jostroeb/hpower_LED_driver/LED_Treiber_Präsentation.pdf

Zielgruppe:
Ziel:

# LED-Beleuchtung

TMT22
Projektvorstellung Leiterplattenentwicklung

Simon Follmann (1134578), Johannes Ströbel (9589176)

# Leiterplattenentwicklung- Projektarbeit

### 4. Dezember 2023

1

3
4
5
6
7

2

Gliederung

Projektidee

Ausblick und Verbesserungsvorschläge

Platinenlayout

LED-Treiber

Mikrocontroller & USB-PD Spannungsversorgung

Anforderungsprofil

Blockschaltbild

ZEISS | 4. Dezember 2023 | 2

Follmann / Ströbel

Follmann

Ströbel

Follmann

Ströbel

Ströbel

Follmann

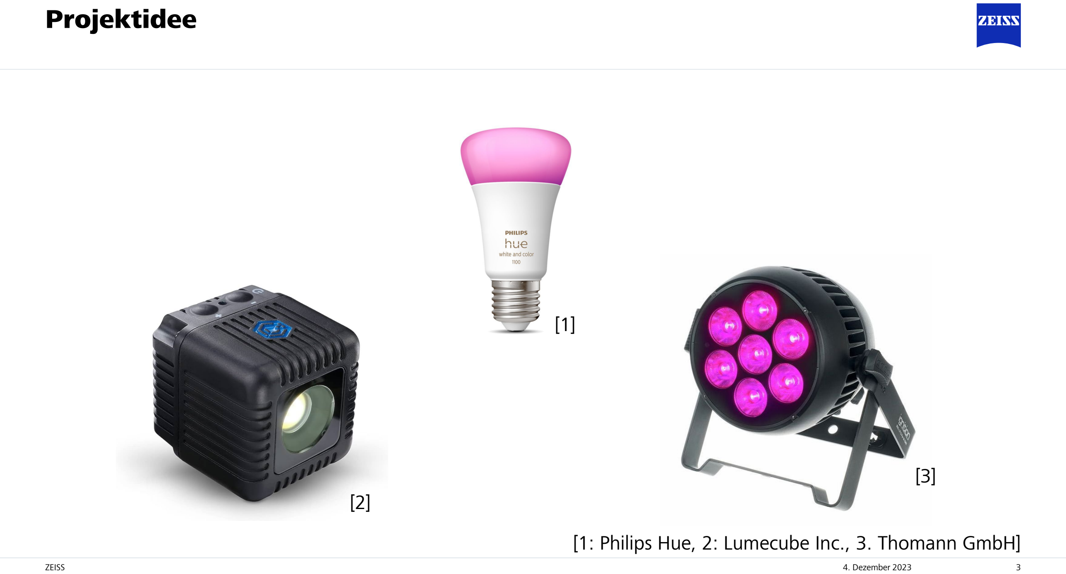
[picture p1: page 3]

Projektidee

[1: Philips Hue, 2: Lumecube Inc., 3. Thomann GmbH]

[1]

[2]

[3]

Anforderungen

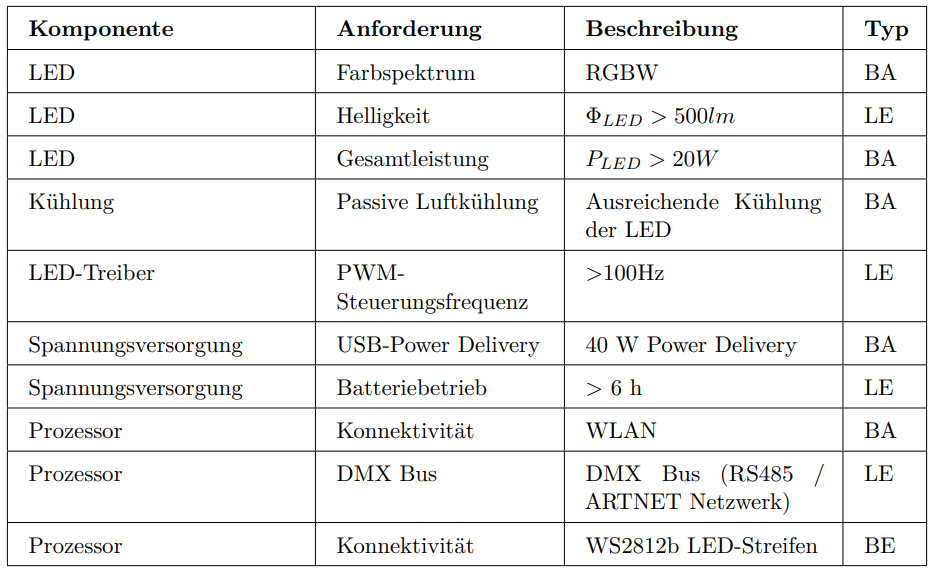
[picture p2: figure]

Blockschaltbild

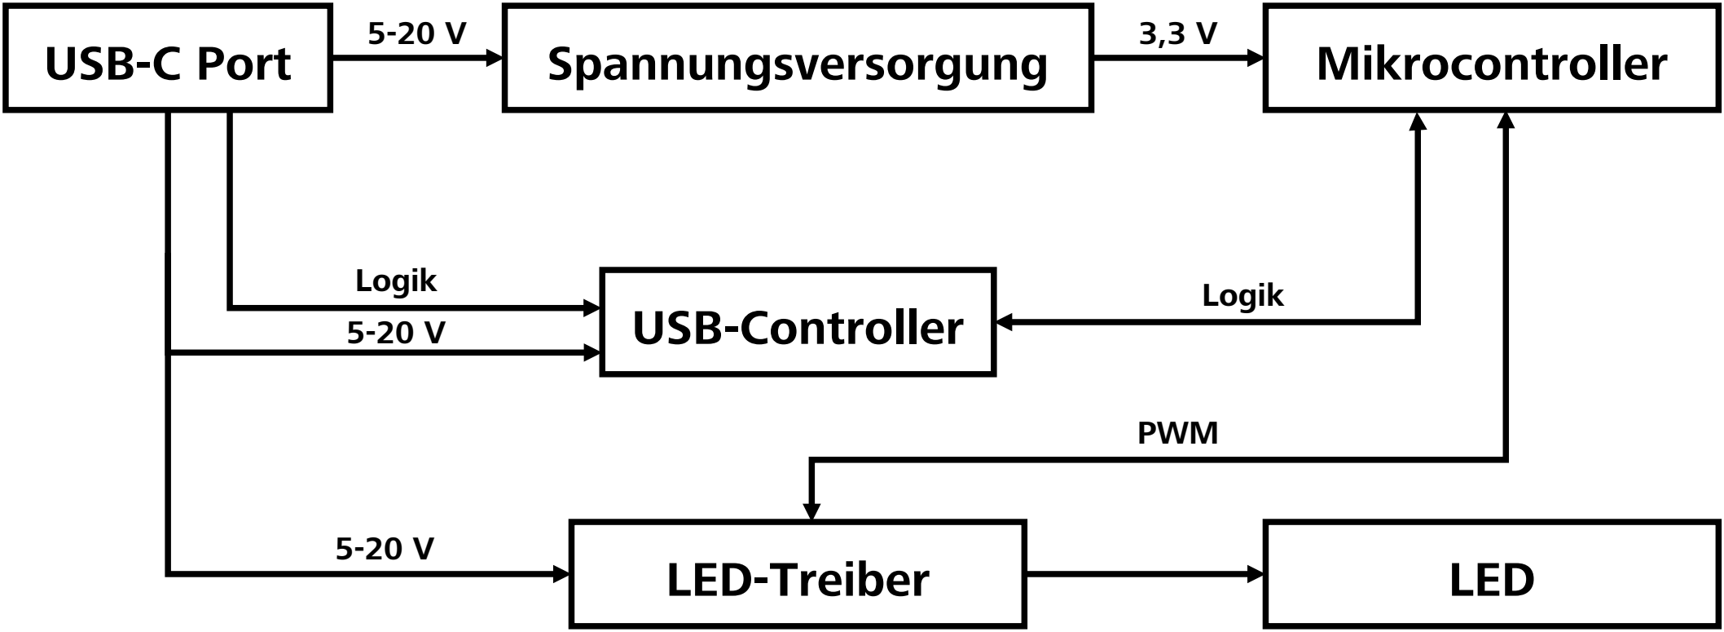
[picture p3: figure]
USB-C Port; USB-Controller; Mikrocontroller; LED-Treiber; LED; Spannungsversorgung; Logik; PWM

Mikrocontroller
Software

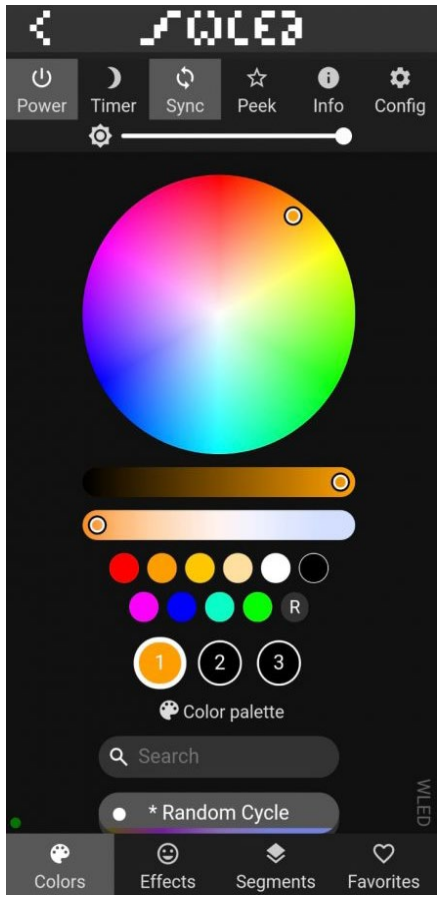
[picture p4: figure]

W-LED
- PWM & Pixelansteuerung
- WLAN Anbindung
- Opensource Software-Projekt
- Browserbasiertes User Interface
- ESP32 kompatibel

Mikrocontroller
Hardware ESP32
- 4 PWM-Pins für LED-Steuerung
- 3,3 V basierter Mikrocontroller
- UART-Schnittstelle für
Programmierung
- Reset und Bootloader Taster
- I2C-Schnittstelle zu USB-Controller
- 2 Input Pins für Fehlermeldung von USB-Controller

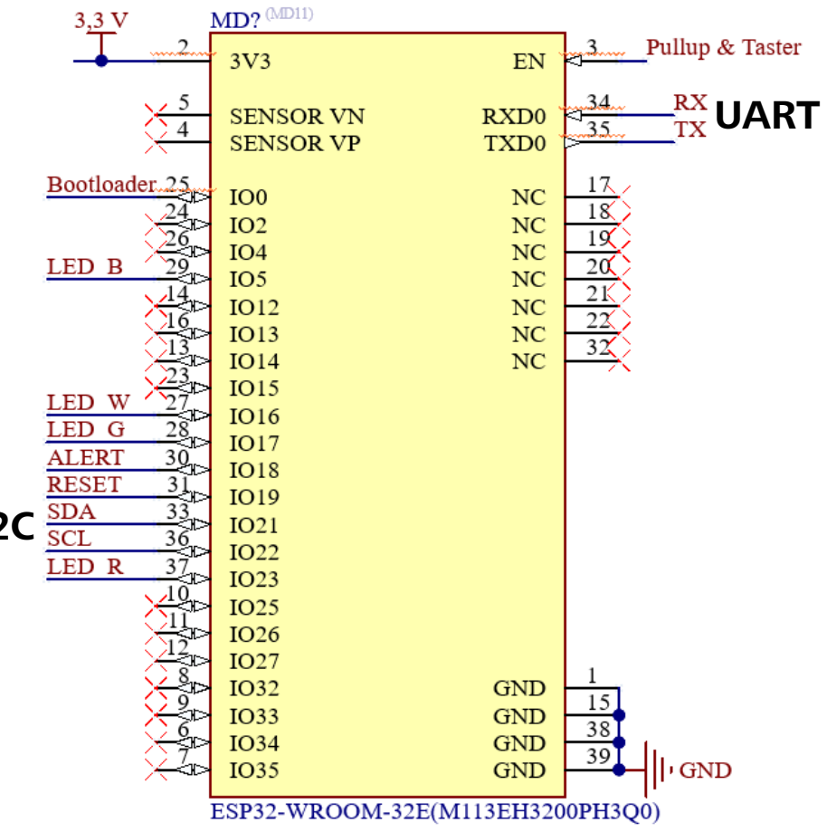
[picture p5: figure]
UART

I2C

USB-Power Delivery Standard Provider-Consumer Beziehung (Source-Sink)

- Kommunikation zwischen Quelle und Senke
- Verhandlung des Power-Contracts

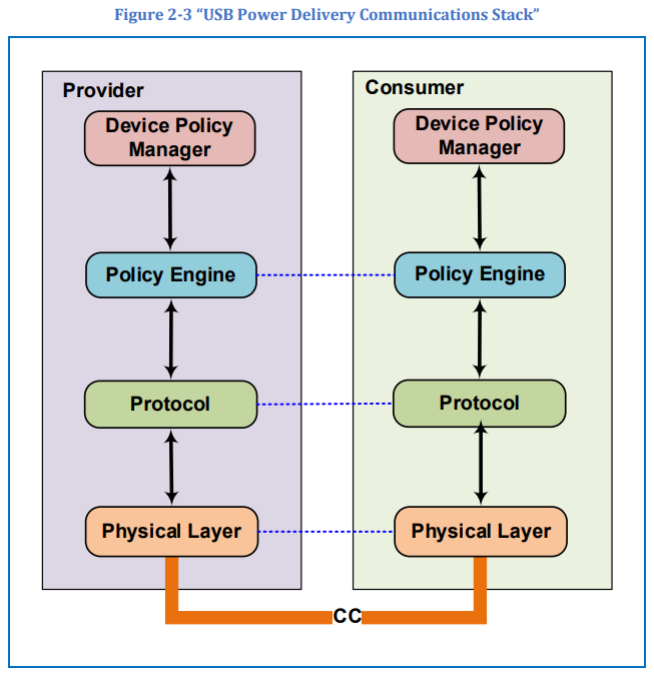
[picture p6: figure]

[usb.org: USB-PD Specification Rev 3.1 2023-10]

USB-Power Delivery Standard Power Data Object (PDO)

Leistungsbereitstellung
abhängig von Netzteil
Pstandby = 3,1 W
Pmax = 37,1 W
→ 5 V 3 A
→ 9 V 2-3 A
→ 15 V 2-3 A (Pmax)
→ 20 V 2 A (Pmax)
Imax = 3A

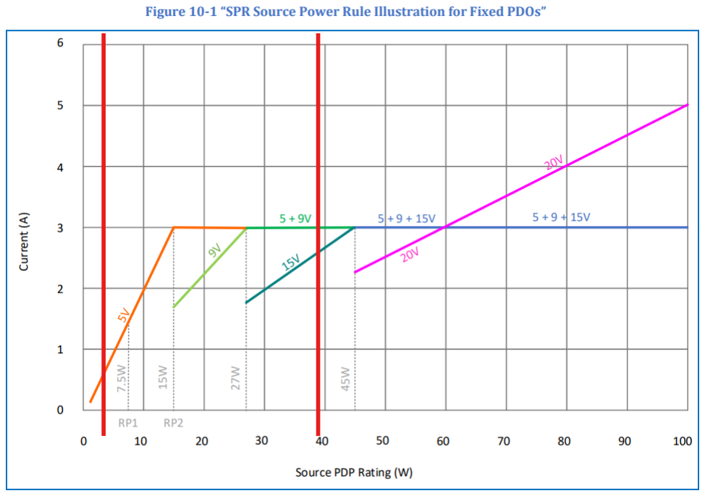
[picture p7: figure]

[usb.org: USB-PD Specification Rev 3.1 2023-10]

USB-Power Delivery Standard Änderung Versorgungsspannung Ubus

5V vSafe → PDO → neue Ubus Power Data Object (PDO) ≈
Leistungsprofil

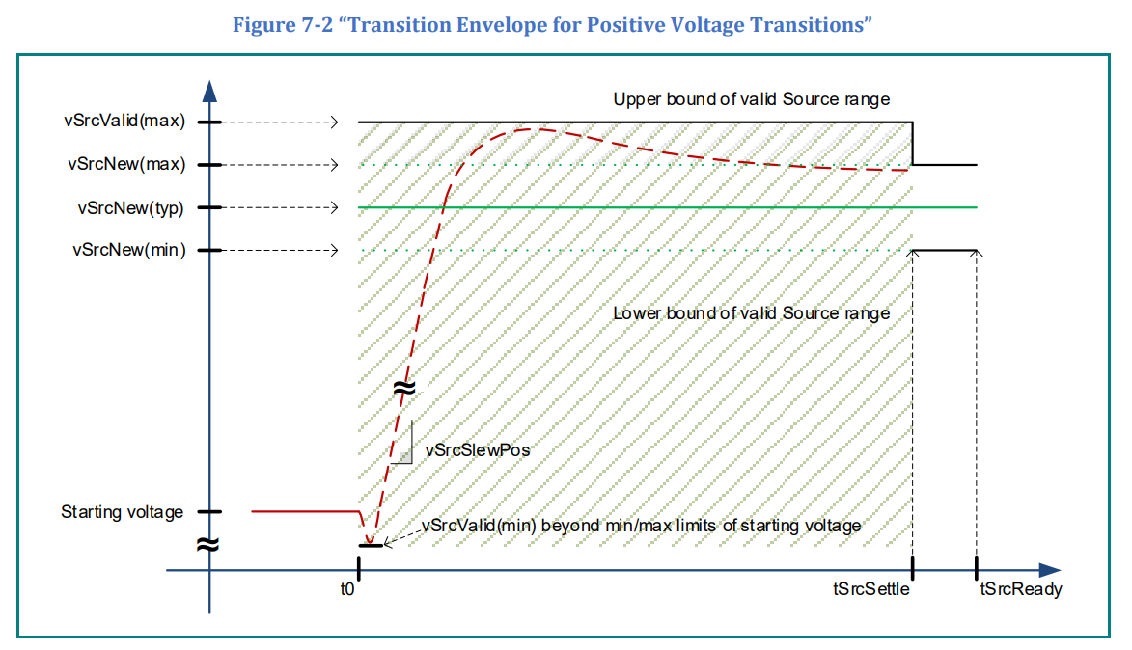
[picture p8: figure]

[usb.org: USB-PD Specification Rev 3.1 2023-10]

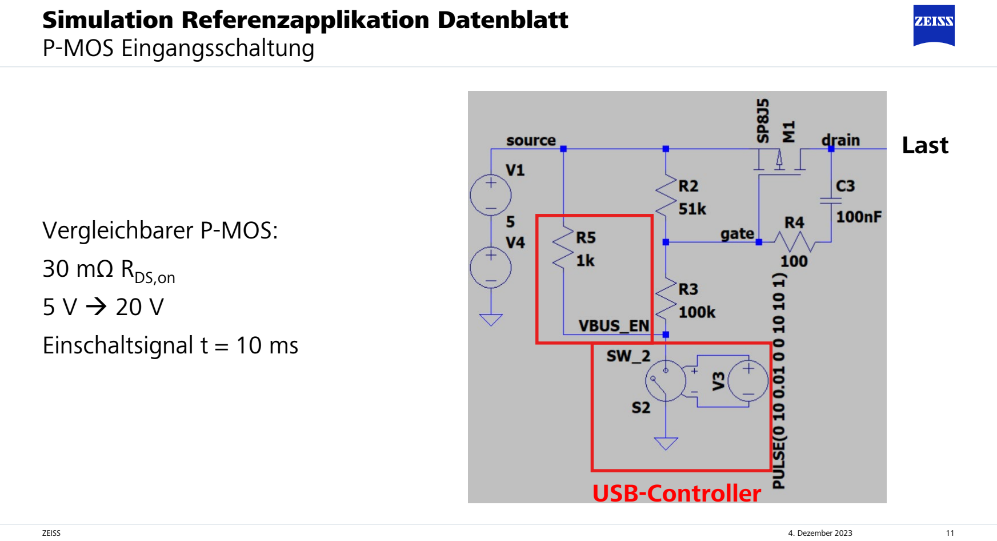
[picture p9: page 11]

Simulation Referenzapplikation Datenblatt P-MOS Eingangsschaltung

Vergleichbarer P-MOS:
30 mΩ RDS,on
5 V → 20 V
Einschaltsignal t = 10 ms

USB-Controller

Last

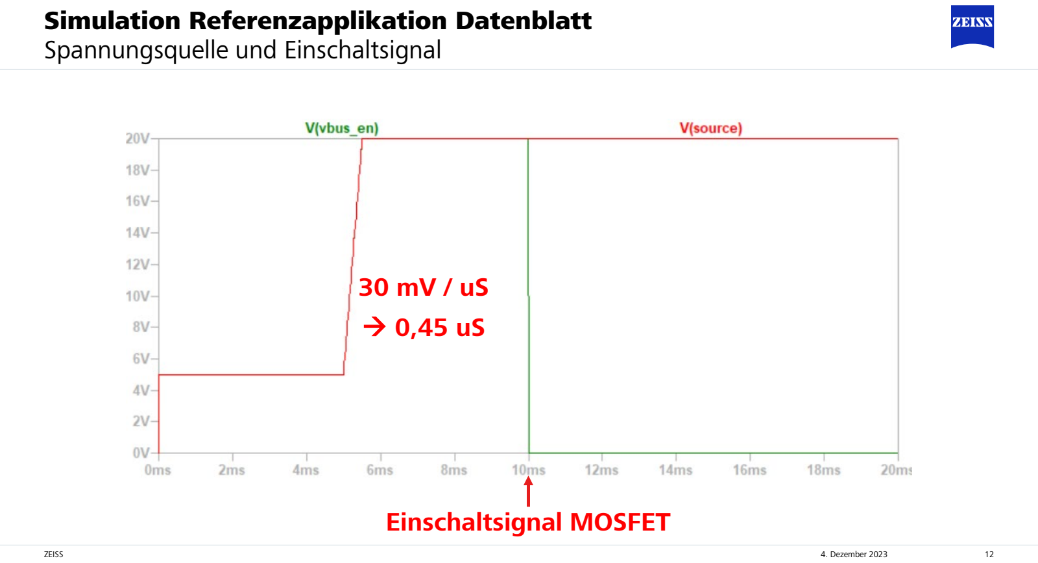
[picture p10: page 12]

Simulation Referenzapplikation Datenblatt Spannungsquelle und Einschaltsignal

Einschaltsignal MOSFET

### 30 mV / uS

→ 0,45 uS

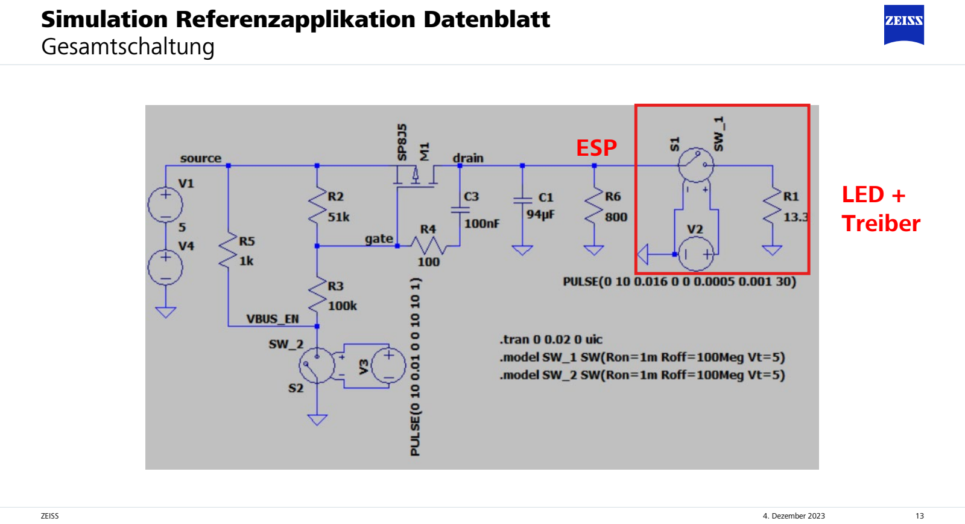
[picture p11: page 13]

Simulation Referenzapplikation Datenblatt Gesamtschaltung

LED +
Treiber

ESP

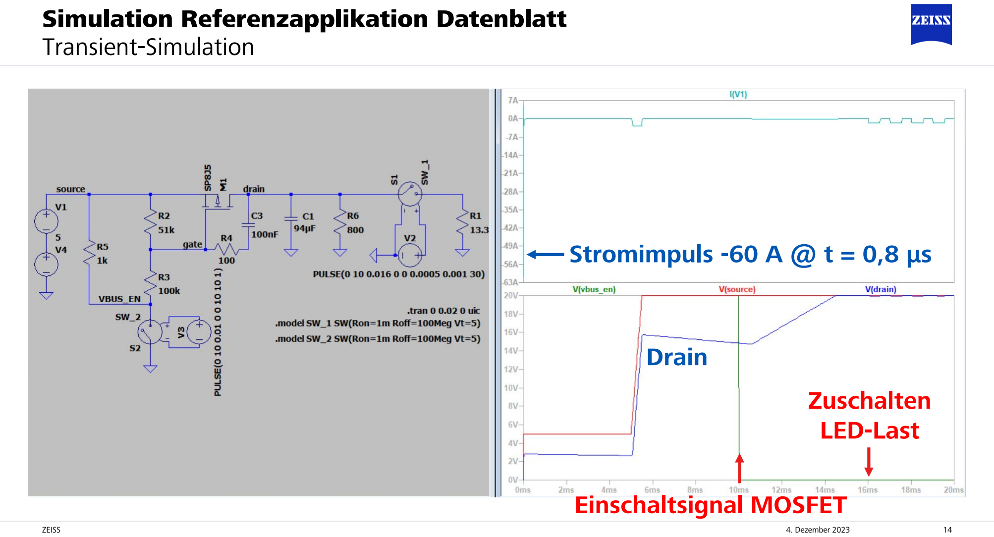
[picture p12: page 14]

Simulation Referenzapplikation Datenblatt Transient-Simulation

Einschaltsignal MOSFET

Zuschalten
LED-Last

Drain

Stromimpuls -60 A @ t = 0,8 µs

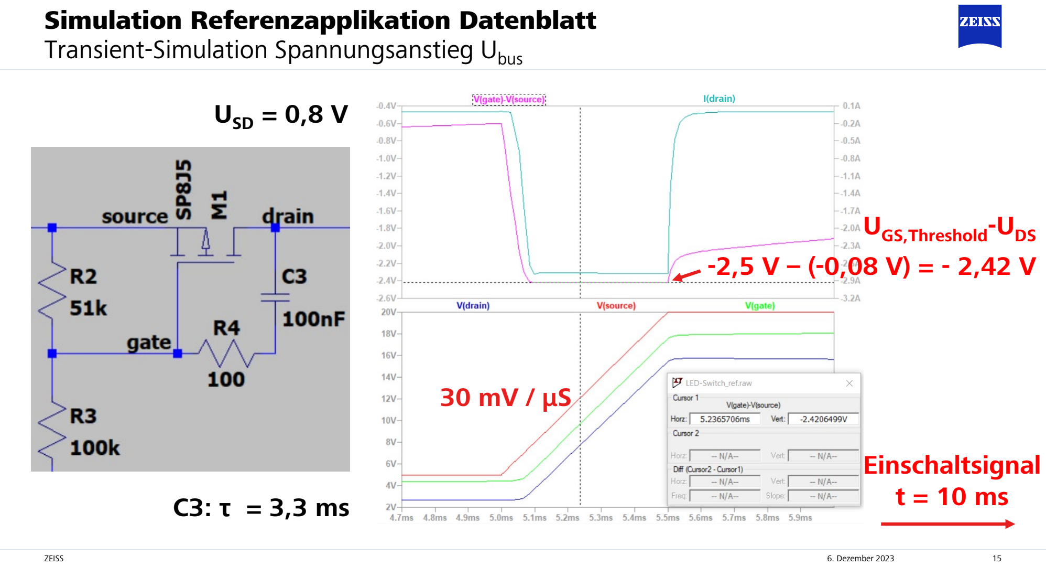
[picture p13: page 15]

Simulation Referenzapplikation Datenblatt Transient-Simulation Spannungsanstieg Ubus

ZEISS | 6. Dezember 2023 | 15

UGS,Threshold-UDS
-2,5 V – (-0,08 V) = - 2,42 V

Einschaltsignal
t = 10 ms C3: τ = 3,3 ms

I(drain)

### 30 mV / µS

USD = 0,8 V

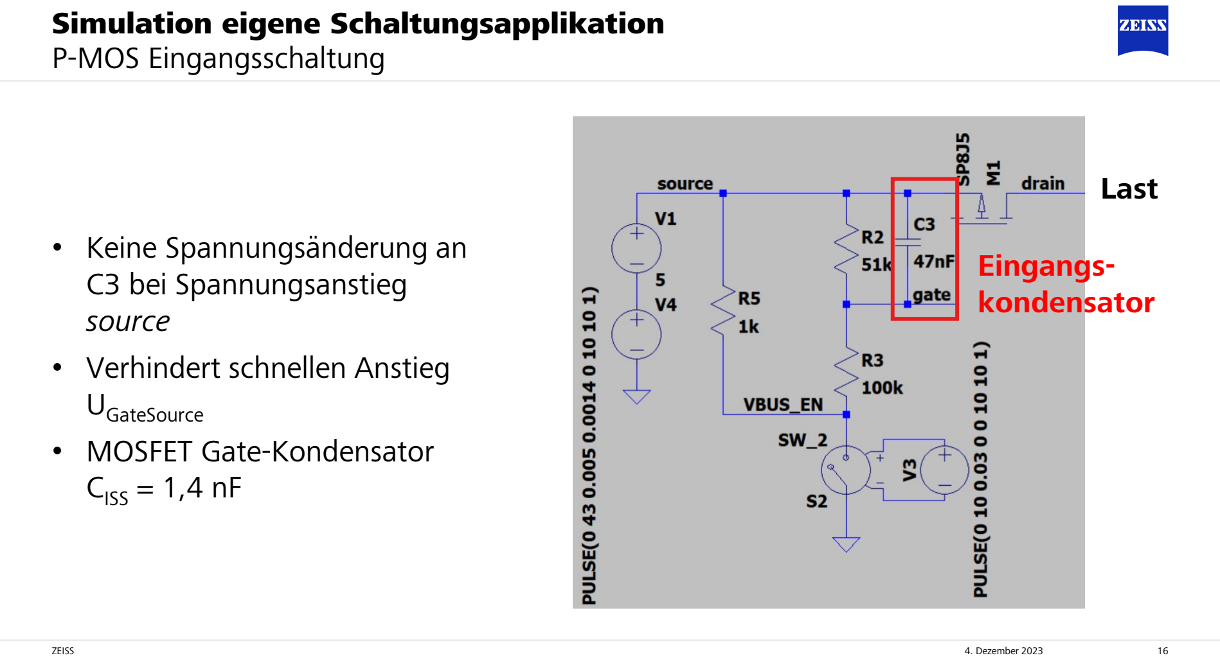
[picture p14: page 16]

Simulation eigene Schaltungsapplikation P-MOS Eingangsschaltung

- Keine Spannungsänderung an C3 bei Spannungsanstieg
source
- Verhindert schnellen Anstieg
UGateSource
- MOSFET Gate-Kondensator
CISS = 1,4 nF

Eingangs-kondensator

Last

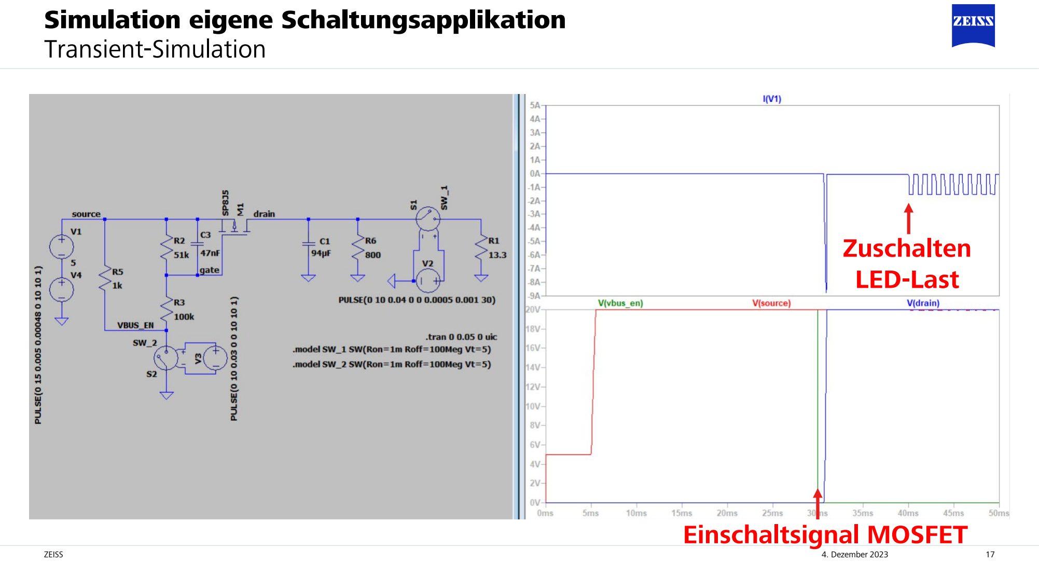
[picture p15: page 17]

Simulation eigene Schaltungsapplikation Transient-Simulation

Einschaltsignal MOSFET

Zuschalten
LED-Last

Simulation eigene Schaltungsapplikation Transient-Simulation UGS

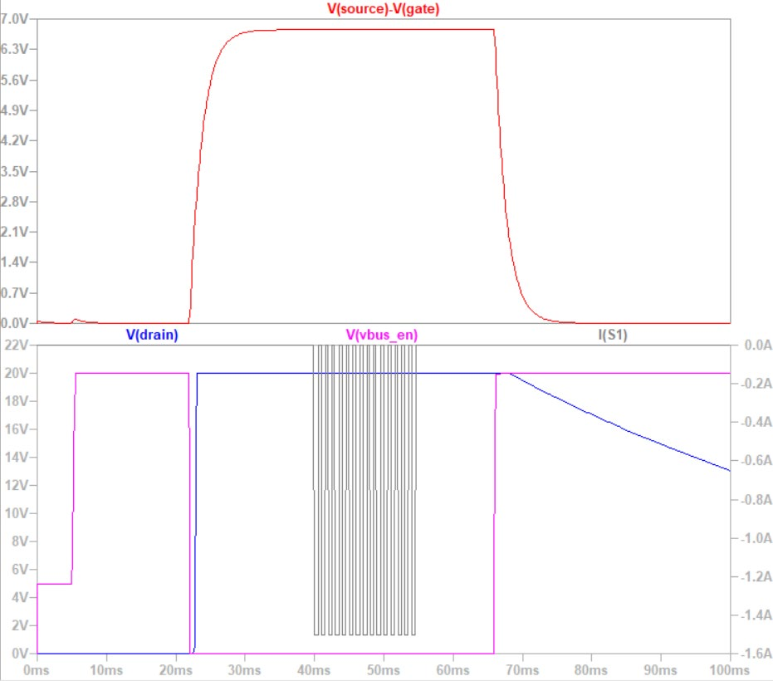
[picture p16: figure]

- Erkennbare Lade/-Entladekurve Kondensator
- Spannungsspitze < Ugs, threshold bei Ugs bei t = 5 ms wegen
Spannungsanstieg,

Simulation Referenzapplikation Datenblatt Transient-Simulation UGS

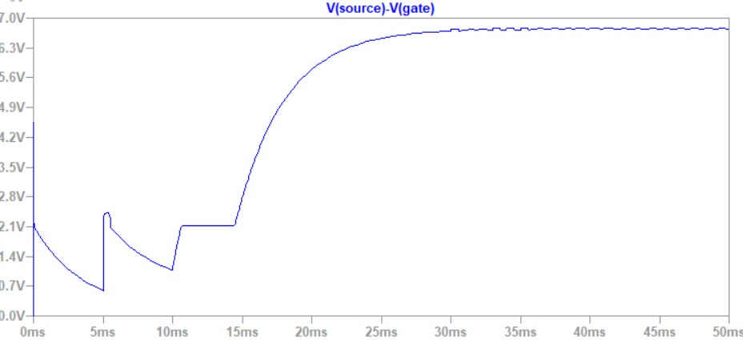
[picture p17: figure]

Unerwünschtes Verhalten

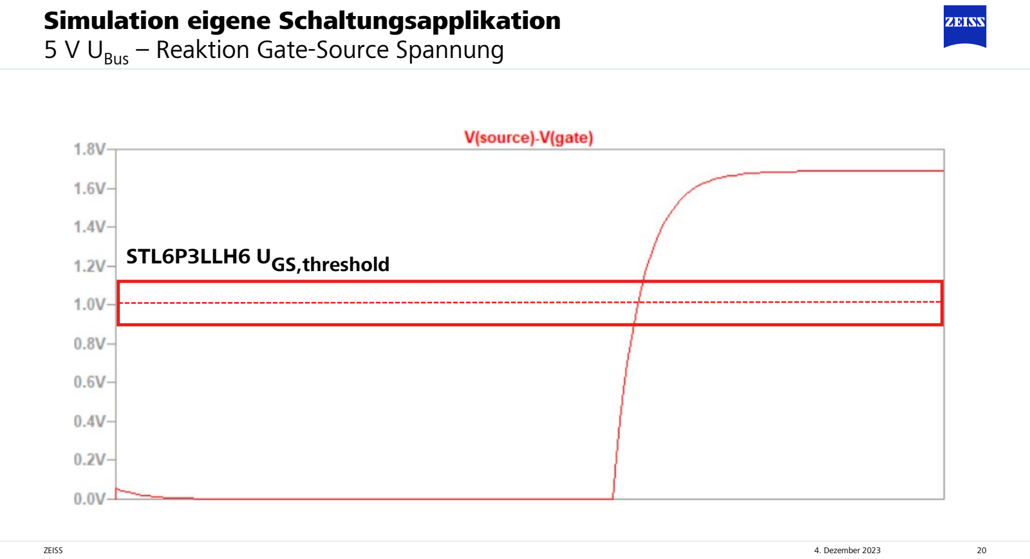
[picture p18: page 20]

Simulation eigene Schaltungsapplikation 5 V UBus – Reaktion Gate-Source Spannung

STL6P3LLH6 UGS,threshold

Simulation eigene Schaltungsapplikation 48 V Bus – Reaktion Gate-Source Spannung

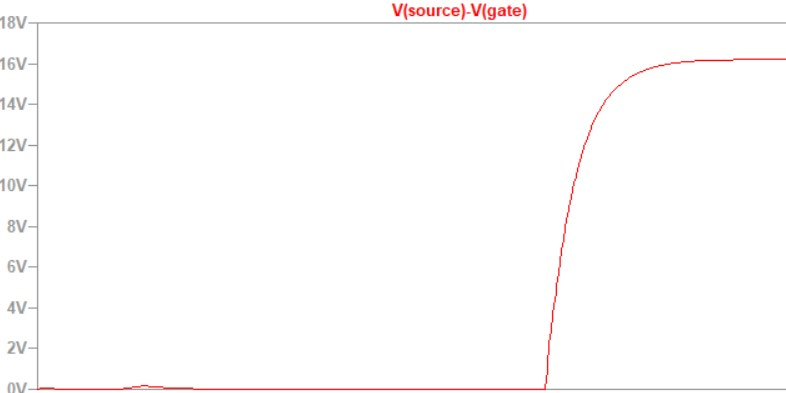
[picture p19: figure]

- Extender Power Range
(bis 48 V / 240 W)
- UGS = ± 20 V
- ESD-Schutzdiode ab 22 V

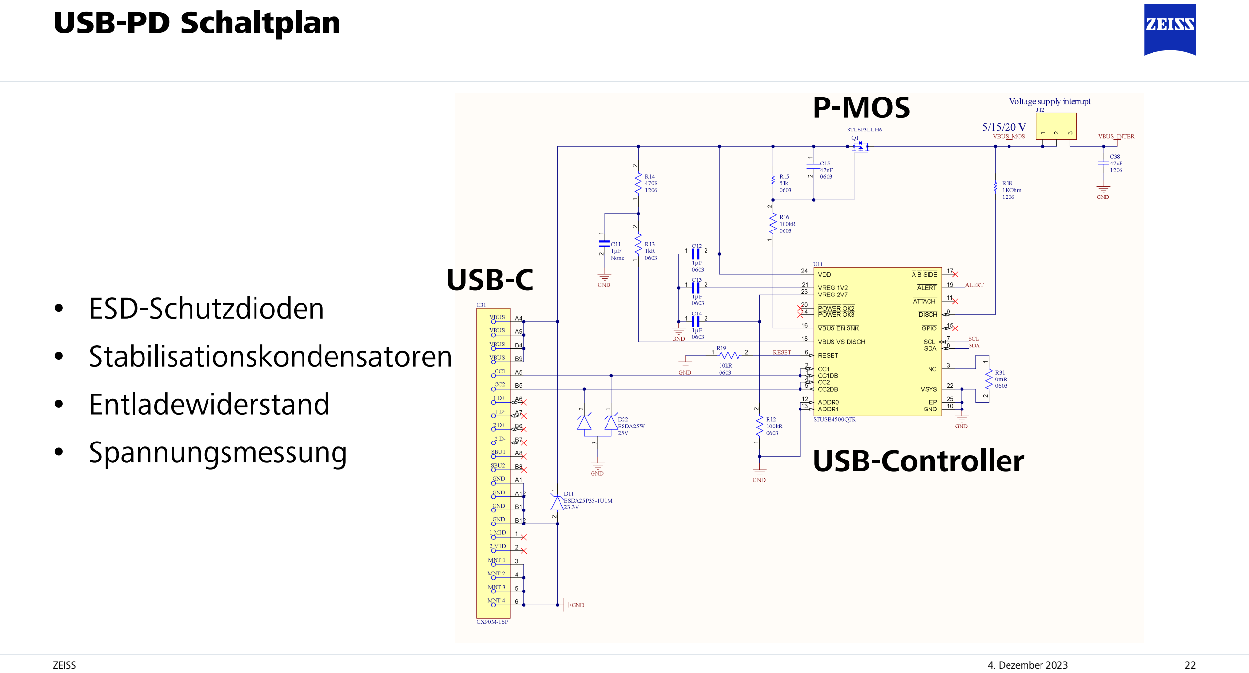
[picture p20: page 22]

USB-PD Schaltplan

- ESD-Schutzdioden
- Stabilisationskondensatoren
- Entladewiderstand
- Spannungsmessung

USB-C

USB-Controller

P-MOS

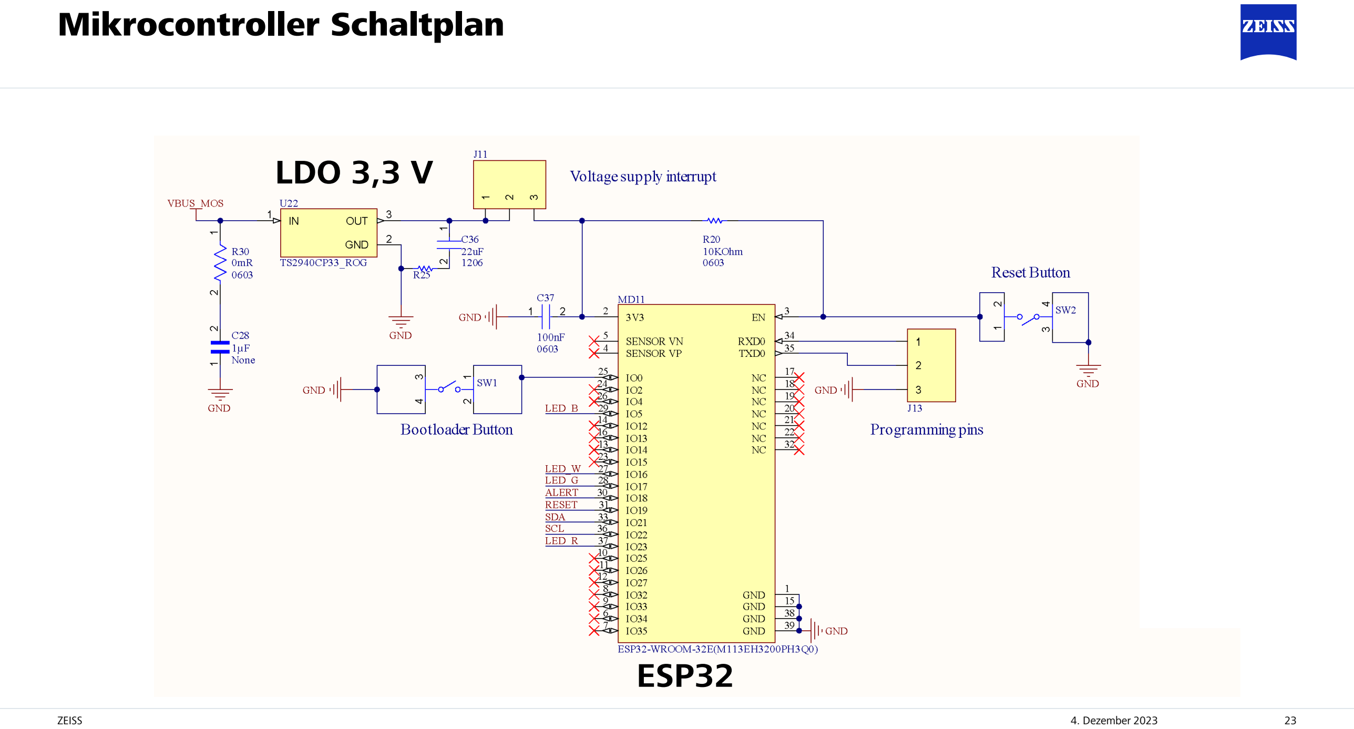
[picture p21: page 23]

Mikrocontroller Schaltplan

ESP32

LDO 3,3 V

LED-Beleuchtungstreiber
Auswahl der LED

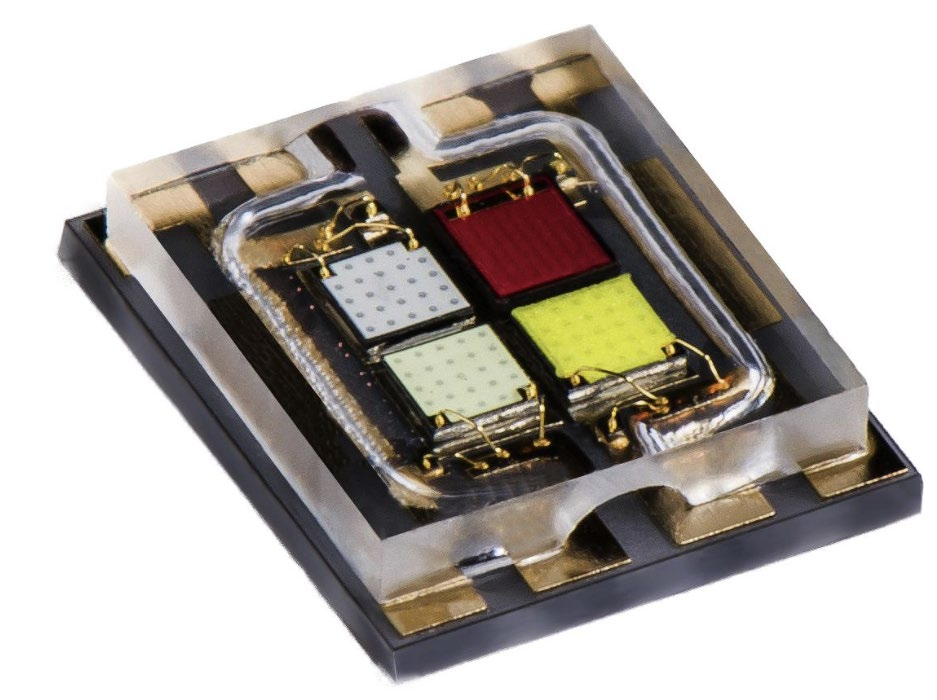
[picture p22: figure]

- Leistung
- Farbvielfalt
- Maximaler Strom Imax = 2A als wichtiger Faktor
- Steuerfrequenz: 1 kHz

Hauptkriterien

LED-Beleuchtungstreiber
Auswahl des LED-Treibers

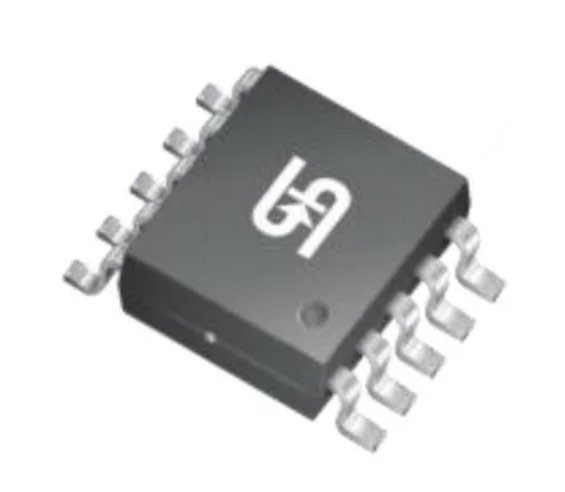
[picture p23: figure]

- Maximalstrom von I
max = 2 A
- Je vier ICs steuern eine Farbe an
- Berücksichtigung von Eingangsspannungsschwankungen durch USB-P (4.5 V – 75 V)
- Hohes Dimmungsverhältnis möglich

Hauptkriterien

LED-Beleuchtungstreiber
Schaltplan

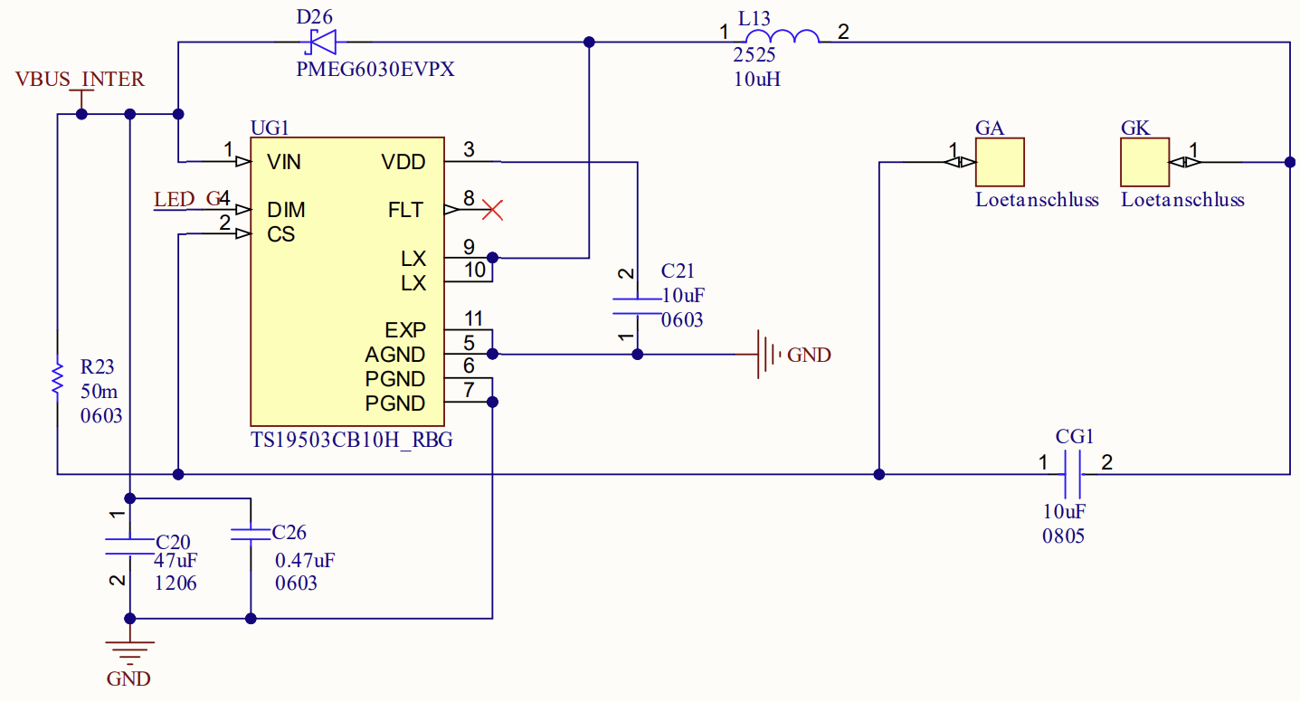
[picture p24: figure]

LED-Beleuchtungstreiber
Berechnung des Stromflusses

https://www.taiwansemi.com/en/products/details/TS19503CB10H

AAABBBBBAAB\

Parameter | Symbol | Non-Dimming | Unit | Remark
Supply Voltage | VIN | 20 | V
Output Voltage | VOUT | 3.9 | V
LED Current | IOUT | 2 | A
Inductor | L | 10 | μH
Ambient Temperature | TC | 25 | ⁰C
Thermal Resistence | RtiJC | 31 | ⁰C/W | Parameter Fixed.
Duty Cycle | D | 21.50 | %
| TON | 1.946 | μs
TOFF | TOFF | 7.65 | μs
Operating Frequency | F | 102.6 | kHz
IC Total Power Dissipation | P | 0.83 | W | PASS
Junction Temperature | TJ | 50.73 | ⁰C

Design Condition

ver.: B2203

System Calculation Form - TS19503CB10H

System Setting TON

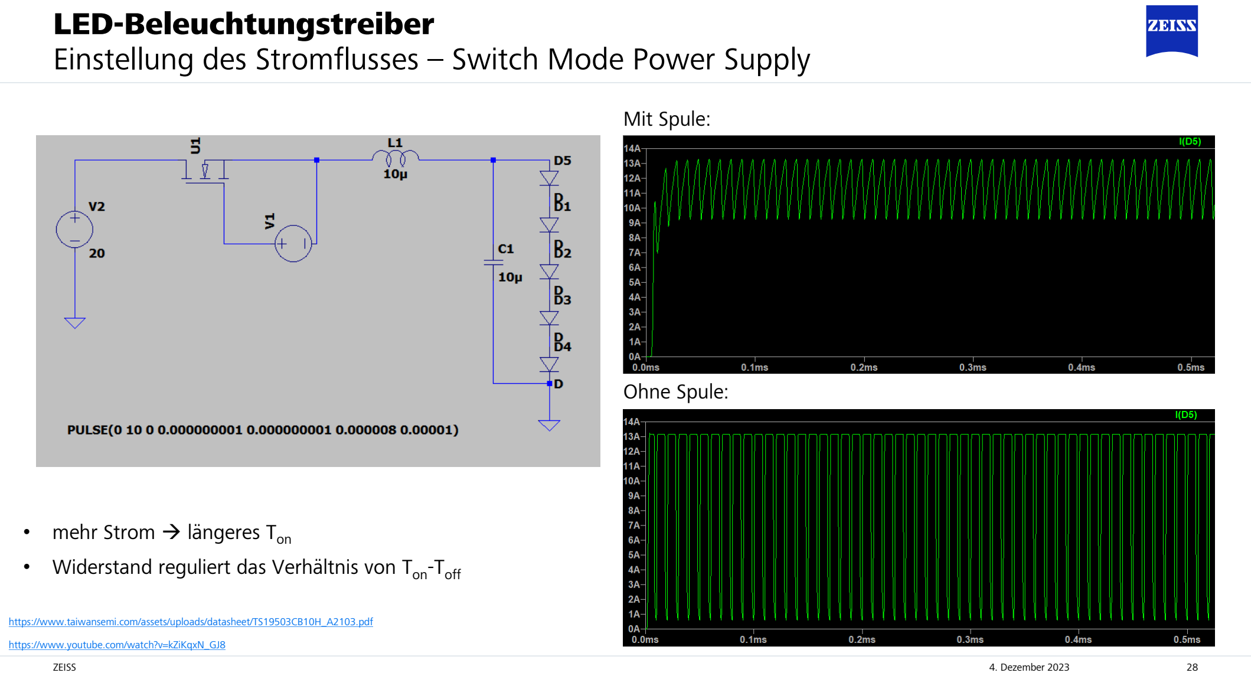
[picture p25: page 28]

LED-Beleuchtungstreiber
Einstellung des Stromflusses – Switch Mode Power Supply

https://www.taiwansemi.com/assets/uploads/datasheet/TS19503CB10H_A2103.pdfhttps://www.youtube.com/watch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

- mehr Strom → längeres Ton
- Widerstand reguliert das Verhältnis von Ton-Toff

Mit Spule:

Ohne Spule:

Kühlung

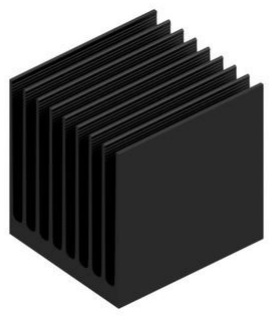
[picture p26: figure]

1.Verlustleistung pro LED
2. Thermische Leistung
3. Gesamte thermische Verlustleistung
4. Maximaler thermischer Widerstand
5. Thermischer Widerstand der PCB
6. Gesamtwiderstand

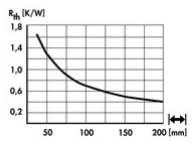
[picture p27: figure]

(Schichten v.u. n. o.: Kühlkörper, Wärmeleitpaste, Alukern (PCB), elektrische Isolation (PCB), Kupfer (PCB), Junction-Case LED)

Layout
LED-PCB

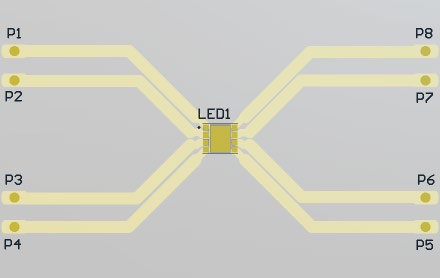
[picture p28: figure]

Layout
3D-Ansicht Oberseite

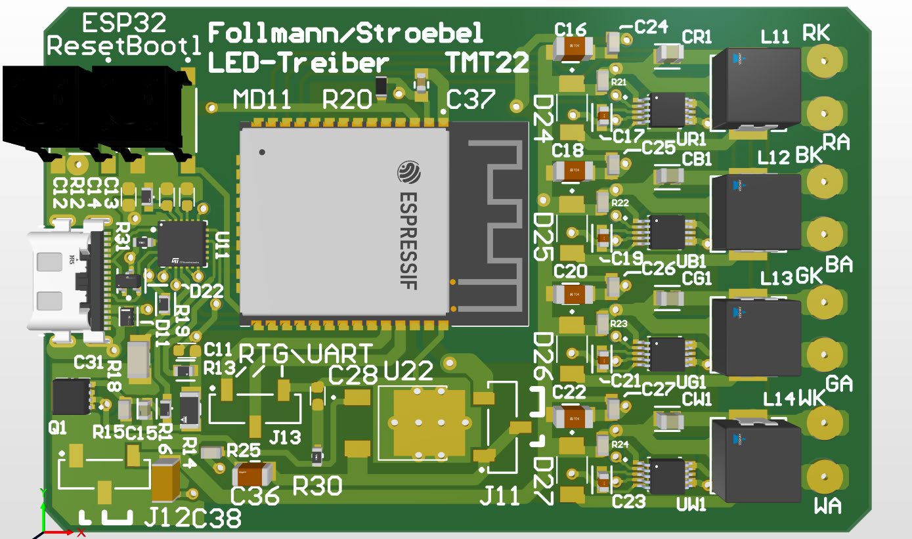
[picture p29: figure]

Bauteilkosten ≈
50 $

Layout
3D-Ansicht Unterseite

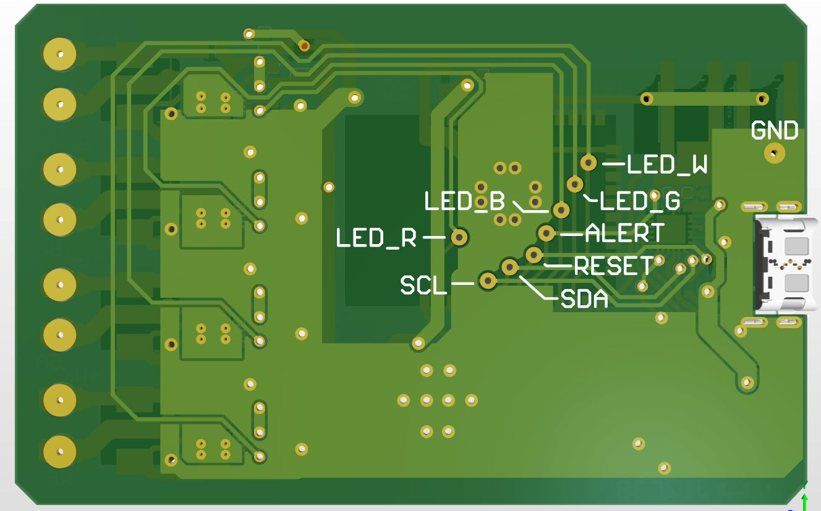
[picture p30: figure]

74 * 47 mm²

Layout
Oberseite

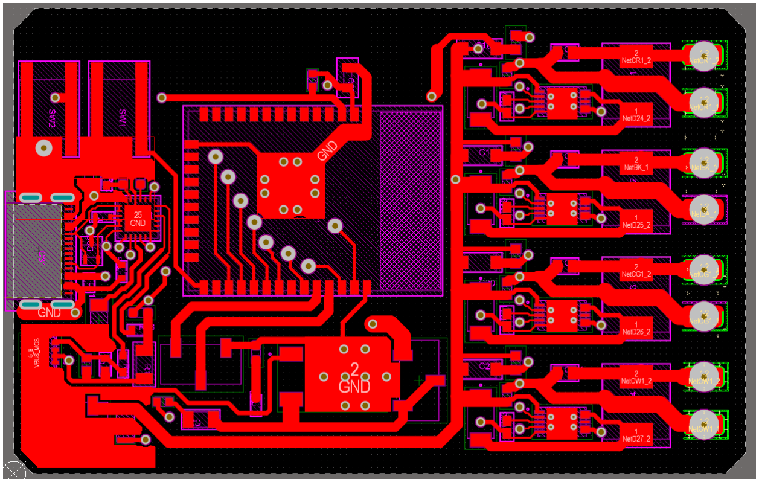
[picture p31: figure]

Layout
Unterseite

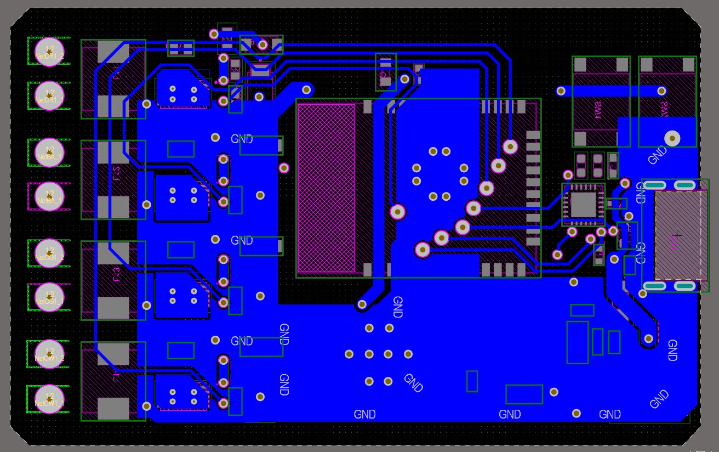
[picture p32: figure]

(links: Trennung P-GND und A-GND von
LED-Treibermodul

Ausblick
Einführung einer Schnittstelle für Displayanschluss

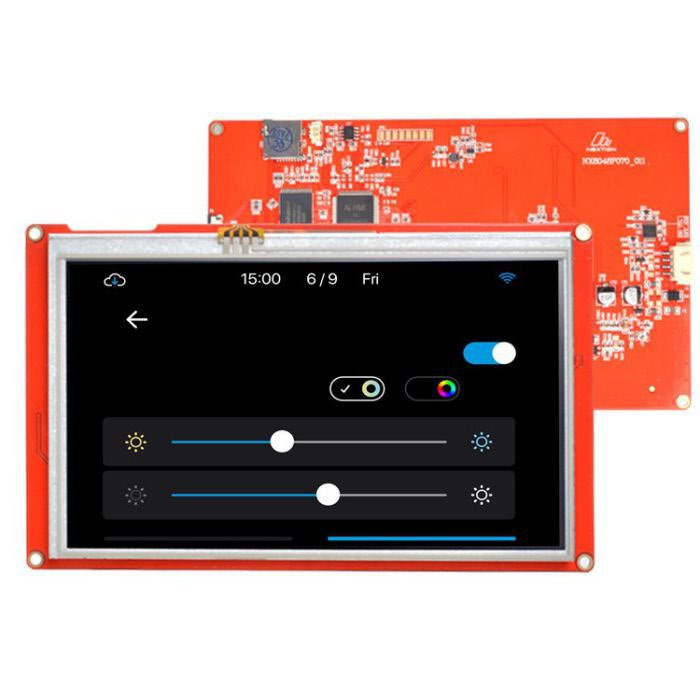
[picture p33: figure]

- Anzeige von Systemparamtern
- Vereinfachte Bedienung und Anpassung
- Zusätzlich weitere Status-LEDs

https://www.antratek.de/nx8048p070-011r

Ausblick
Erweiterung des Farbspektrums

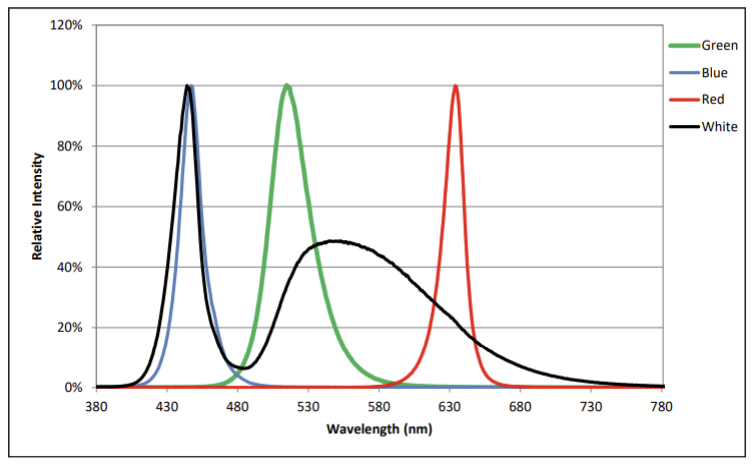
[picture p34: figure]

- Neue Spektren: UV, Amber etc.
- Neue Einsatzgebiete des Treibers
- Verbesserte Farbwiedergabe und Farbbandbreite
- Allgemeine Steigerung der Funktionalität des Systems

https://www.visiontwo.de/marken/claypaky/led-moving-lights/k-eye-k20-hcr/

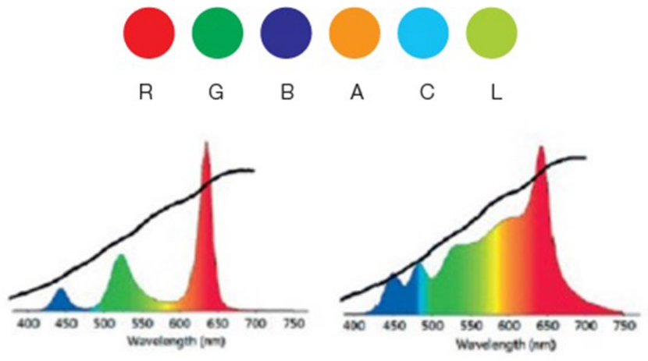
[picture p35: figure]

https://www.mouser.de/datasheet/2/245/Luminus_SBM_40_SC_Datasheet-1499187.pdf

Ausblick
Integration einer DMX-Bus-Schnittstelle
- Professionelle und flexible Steuerung des LED-Treibers
- Vernetzung mehrerer Treiber zu einem koordinierten LED-System
- Adressierbarkeit von LEDs
- Einsatz in umfangreichen Bühnensystemen

https://www.production-partner.de/basics/dmx-%E2%88%92-grundlage-der-lichtsteuerung/

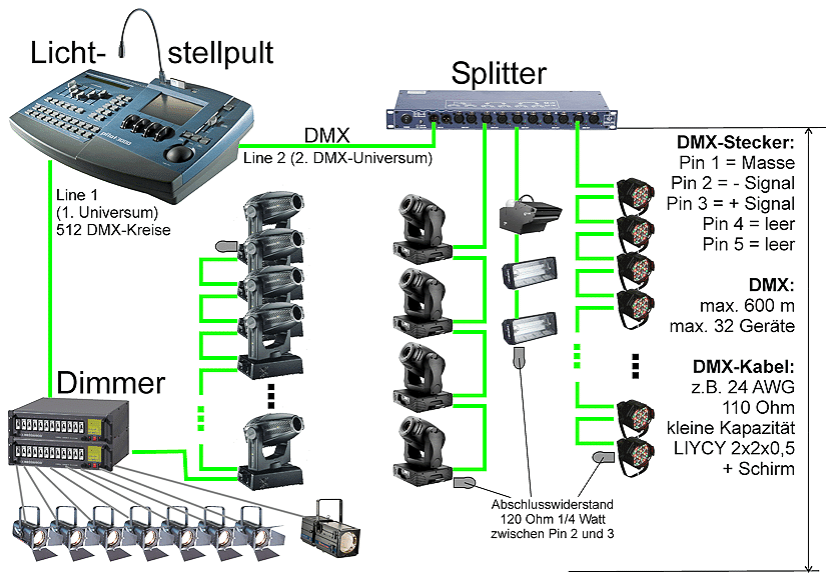
[picture p36: figure]

Ausblick
Verbesserung der Kühlung
- Effizientere Kühlkörper für Treiber und LED-Board
- Verlängerte Lebensdauer der Komponenten durch optimale Wärmeabfuhr
- Verbesserung auf Basis von Temperaturmessungen
- Gezielte Kühlung kritischer Komponenten
- Zentraler Kühlkörper zur Kühlung des Treiber- und LED-Boards

Ausblick
Integration einer neueren ESP-Version
- Verbesserte Effizienz eines zentralen Systembauteils
- Unterstützung komplexerer Steuerungslogik
- Verbesserte Verarbeitungsleistung
- Erweiterung von verwendbaren Schnittstellen

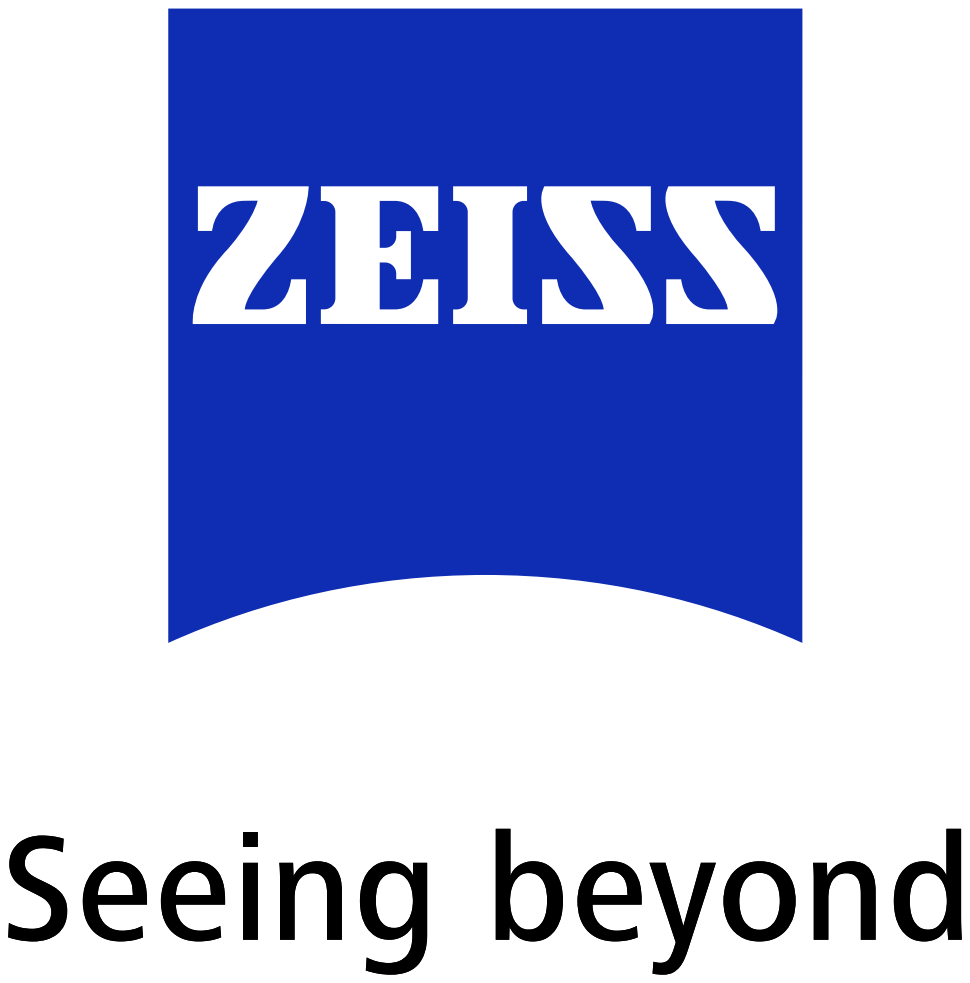
[picture p37: page 40]
