jostroeb/hpower_LED_driver/LED_Treiber_Dokumentation.pdf

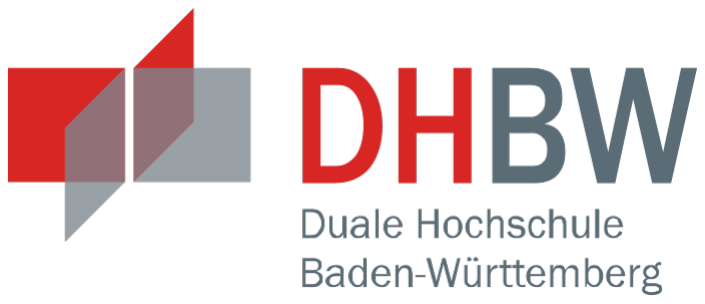
[picture p38: figure]

## Entwicklung eines LED-Treibers

Projektarbeit

im Modul

Leiterplattenentwicklung

des Studiengangs Mechatronik

an der Dualen Hochschule Baden-Württemberg Heidenheim

von

Simon Follmann, Johannes Ströbel

Dezember 2023

Bearbeitungszeitraum | 12 Wochen
Matrikelnummer, Kurs | 1134578 (Fo.), 9589176 (St.), TMT22A
Ausbildungsbetrieb | Carl Zeiss AG, Oberkochen

## Erklärung

Wir versichern hiermit, dass wir unsere Projektarbeit mit dem Thema: Entwicklung eines LED-Treibers selbstständig verfasst und keine anderen als die angegebenen Quellen und Hilfsmittel benutzt haben. Wir versichern zudem, dass die eingereichte elektronische Fassung mit der gedruckten Fassung übereinstimmt.

Heidenheim, Dezember 2023

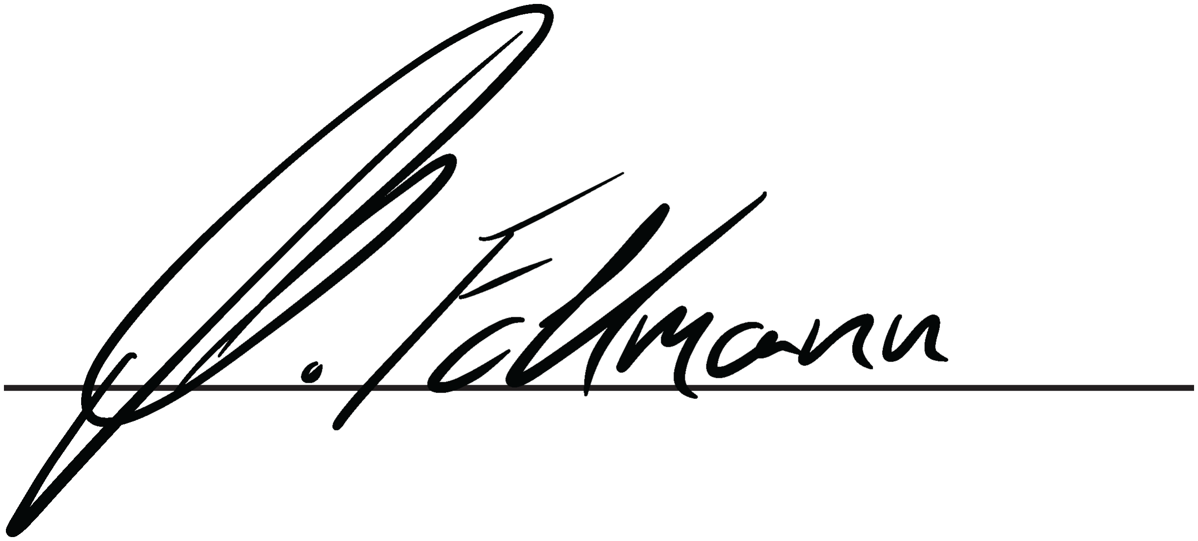
[picture p39: figure]
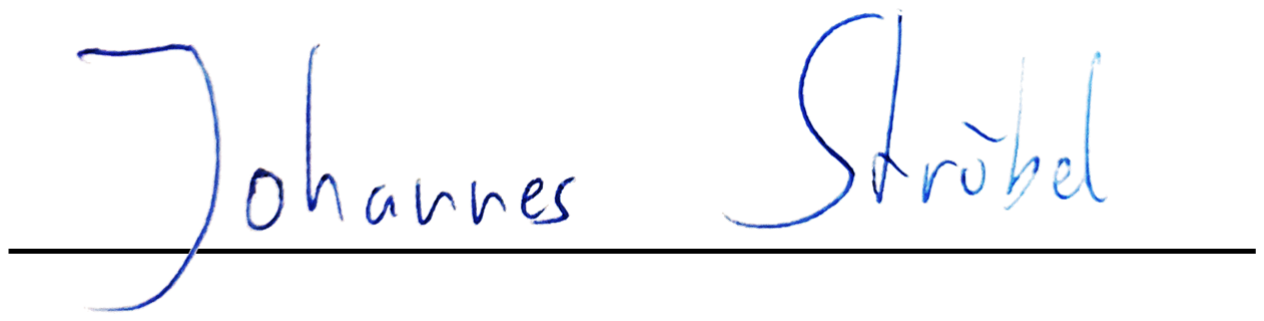
[picture p40: figure]

Simon Follmann | Johannes Ströbel

# Inhaltsverzeichnis

Abkürzungsverzeichnis | III
Abbildungsverzeichnis | IV
Tabellenverzeichnis | V
1. Einleitung | 1
2. Anforderungen | 2
3. Bauteile und Schaltplan | 4
4. Leiterplattenlayout | 17
5. Ausblick und Verbesserungsmöglichkeiten | 20
Anhang | 21

II

# Abkürzungsverzeichnis

ESR | Ersatzreihenwiderstand
GND | Ground
I2C | Inter-Integrated Circuit Bus
IC | Integrated Circuit (dt. Integrierter Schaltkreis)
MOSFET | Metalloxid Semiconductor Feldeffekt Transistor
NC | Not Connected
RX | Receiving Pin Universal Asynchronous Receiver / Transmitter Bus (UART)
SCL | Serial Clock
SDA | Serial Data
Source | Universal Serial Bus (USB) Netzteil
TX | Transmitter Pin UART
UART | Universal Asynchronous Receiver / Transmitter Bus
USB | Universal Serial Bus
USB-C | USB Typ C Stecker

USB-Controller Mikrocontroller zur Vereinbarung von USB-PD Leistung

USB-PD | USB Power Delivery
PCB | Printed Circuit Boards

Power-Contract Vereinbarung über Leistung zwischen Netzteil und Verbraucher

PWM | Pulsweitenmodulation

III

# Abbildungsverzeichnis

2.1. Verfügbare USB Power Delivery (USB-PD) Spannungen nach Table 10-2
USB-Spezifikation [usb.2017] | 2
3.1. Blockschaltbild mit Mikrocontroller, USB-Controller, LED-Treiber und LED 4
3.2. Schaltplan der USB-PD Spannungsversorgung mit STUSB4500 USB-Controller 5
3.3. Output Characteristics Diagramm aus [stm.2020] | | 6
3.4. Schaltungsaufbau nach Referenzapplikation [stm.2022] | | 7
3.5. Spannungsverlauf an UBus = V(source) und Einschaltsprung bei 10 ms . . | 8
3.6. Transienten-Simulation der Referenzapplikation mit Selbsteinschalteffekt
des Metalloxid Semiconductor Feldeffekt Transistors (MOSFETs) bei t =
0ms und t ≈ 5 ms | | 8
3.7. Detailansicht der Simulation mit errechnet UGS oben | | 9
3.8. Eigener Schaltungsaufbau mit geänderter Gate Konfiguration am MOSFET 10
3.9. Simulation des eigenen Schaltungsaufbaus mit Einschaltsignal bei t = 30 ms 11
3.10. Gate-Source-Spannung am MOSFET mit Einschalten bei t = 30 ms . . . . 11
3.11. Schaltplan des ESP32 und Spannungsversorgung | 12
4.1. Oberseite der Platine mit leitender Schicht in Rot | 17
4.2. Unterseite der Platine mit leitender Schicht in Blau | 18
4.3. 3D-Modell der Platine mit Bemerkungen auf der Platine in Gelb | 18
4.4. Platine aus Aluminium mit aufgelötetem Stecker | 19

IV

# Tabellenverzeichnis

2.1. Zusammengefasste Anforderungen für Kühlung, LED-Treiber und LED . . 3

V

# 1. Einleitung

In diesem Studentenprojekt wird die Auslegung eines Hochleistungs-LED-Treibers präsentiert. Das Projekt umfasst die vollständige Entwicklung des Treibers, angefangen bei der Konzeption bis hin zum Design, der Schaltungsüberprüfung, der Auswahl der Komponenten, und dem Aufbau der Leiterplatten. Diese bestehen aus einem separaten Treiber- und einem LED-Board.

Das primäre Ziel dieses Projekts ist die Entwicklung eines effizienten und leistungsfähigen LED-Treibers, der eine RGBW-LED mit hoher Leistung versorgen kann. Als Leistungsquelle dient der USB-PD Standard, um die Implementierung dessen für zukünftige Projekte im Rahmen des Studiums oder der Praxisphasen kennen zu lernen.

Die vorliegende Dokumentation bietet einen nachvollziehbaren Überblick über die einzelnen Entwicklungsschritte und dient als detaillierter Leitfaden für die Projektarbeit. Sie reflektiert nicht nur das im Zuge des Projekts erworbene Wissen, sondern demonstriert auch die praktische Anwendung der in der Vorlesung erlernten Inhalte und Reflexion über den Erfolg des Projektes und die Funktion der Bauteile.

# 2. Anforderungen

Im Nachfolgenden finden sich die Anforderungen, welche an die entwickelte Leiterplatte gestellt sind. Dabei wird separat auf die Leistungsanforderung sowie die Anforderungen an das Gesamtsystem eingegangen.

## 2.1. USB-Power Delivery

Zur Spannungsversorgung des Systems wird der USB-PD Standard verwendet. Dieser erlaubt die Nutzung verschiedener Spannungen und möglicher Ströme je nach verwendeter USB Netzteil (Source). Laut dem USB Protokoll sind hierfür folgende Werte möglich:

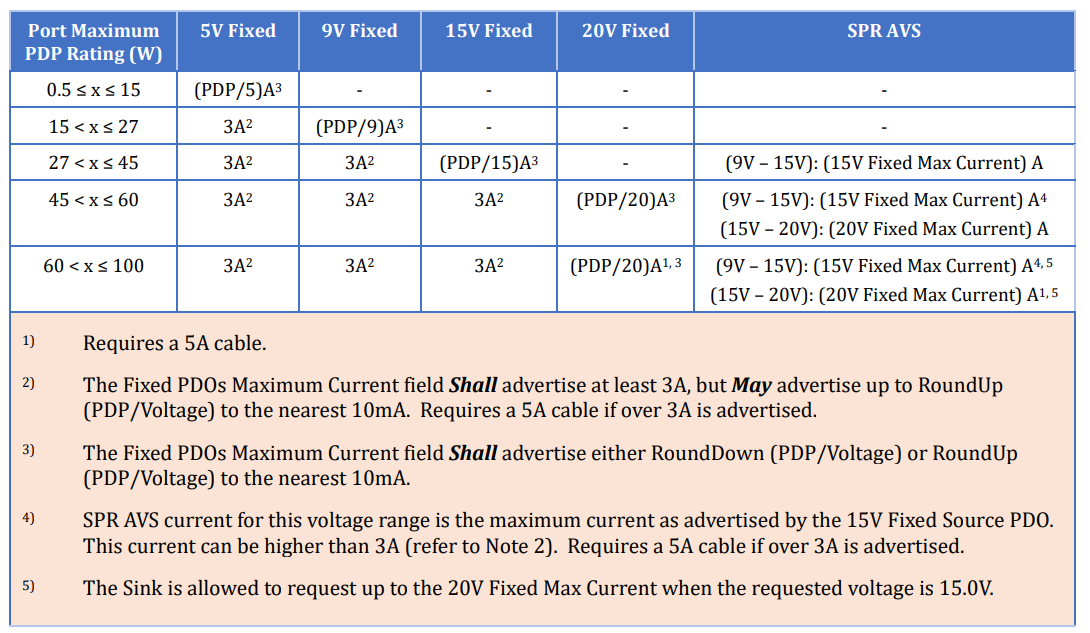
[picture p41: figure]

Abbildung 2.1.: Verfügbare USB-PD Spannungen nach Table 10-2 USB-Spezifikation [usb.2017]

Da verschiedene Netzteile oft typische Werte aufweisen, werden folgende Vereinbarung über Leistung zwischen Netzteil und Verbrauchers (Power-Contracts) verwendet: 5 V bei 3 A, 15 V bei 3 A und 20 V bei 2 A. Je nach Netzteil wird der höchste verfügbare Wert gewählt.

2. Anforderungen

## 2.2. Anforderungsliste

Die Anforderungsliste gibt einen Überblick über alle zu erfüllenden Anforderungen. Dabei wird unterschieden in Basisanforderungen (BA), Leistungsanforderungen (LE) und Begeisterungsanforderungen (BE).

Komponente | Anforderung | Beschreibung | Typ
LED | Farbspektrum | RGBW | BA
LED | Helligkeit | ΦLED > 500lm | LE
LED | Gesamtleistung | PLED > 20W | BA
Kühlung | Passive Luftkühlung | Ausreichende Kühlung der LED | BA
LED-Treiber | PWM-Steuerungsfrequenz | >100Hz | LE
Spannungsversorgung | USB-Power Delivery | 40 W Power Delivery | BA
Spannungsversorgung | Batteriebetrieb | > 6 h | LE
Prozessor | Konnektivität | WLAN | BA
Prozessor | DMX Bus | DMX Bus (RS485 / ARTNET Netzwerk) | LE
Prozessor | Konnektivität | WS2812b LED-Streifen | BE

Tabelle 2.1.: Zusammengefasste Anforderungen für Kühlung, LED-Treiber und LED

# 3. Bauteile und Schaltplan

Im folgenden Kapitel werden die elektronischen Bauteile beschrieben, deren Funktion im gesamten System erklärt, sowie die Auslegung bewiesen. Das Blockschaltbild des Projektes beinhaltet die relevanten Komponenten, sowie deren Beziehung zueinander:

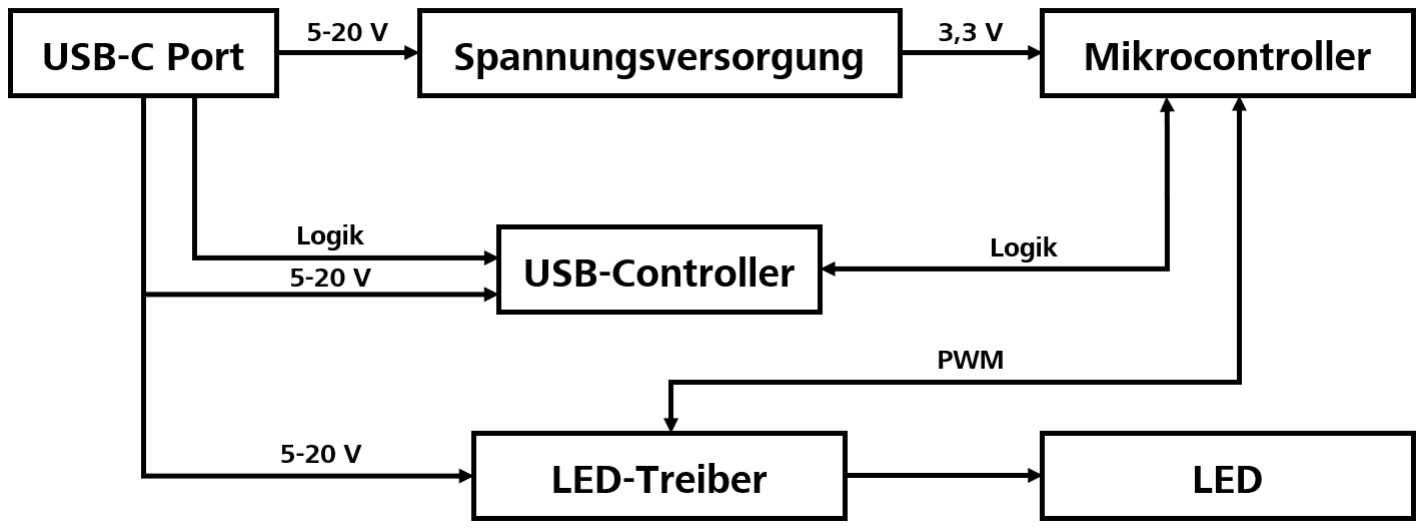
[picture p42: figure]

Abbildung 3.1.: Blockschaltbild mit Mikrocontroller, USB-Controller, LED-Treiber und LED

Das Blockschaltbild wird im Schaltplan (s. Anhang) konkret umgesetzt. Zuerst wird nachfolgend die Spannungsversorgung mittels USB-PD betrachtet. Diese ist ausschnittsweise in Grafik 3.2 dargestellt.

## 3.1. USB-C Spannungsversorgung

Da die Spannungsversorgung nach USB-PD Standard mit einem USB Typ C Stecker (USB-C) Anschluss erfolgt, wird zur Kommunikation über verfügbare Leistung zwischen Spannungsversorgung und Verbraucher ein Mikrocontroller zur Vereinbarung von USB-PD Leistung (USB-Controller) zur Steuerung verwendet. Hierbei handelt es sich um den STUSB45000QTR. Dieser kann zwischen drei Power-Contracts wählen, sowie mit Inter-Integrated Circuit Bus (I2C) programmiert werden.

Auf der Platine ist die Spannungsquelle der USB-C Anschluss, von welchem die Anschlüsse für VBus, CC1, CC2 zur Vereinbarung des Power-Contracts und Ground ausgehen. Zum Schutz der CC1 und CC2 Eingängen des USB-Controller vor hohen Spannungsspitzen bis 25 kV sind diese jeweils mit einer Z-Diode mit einer Durchbruchspannung von UBR, max. = 30 V

3. Bauteile und Schaltplan

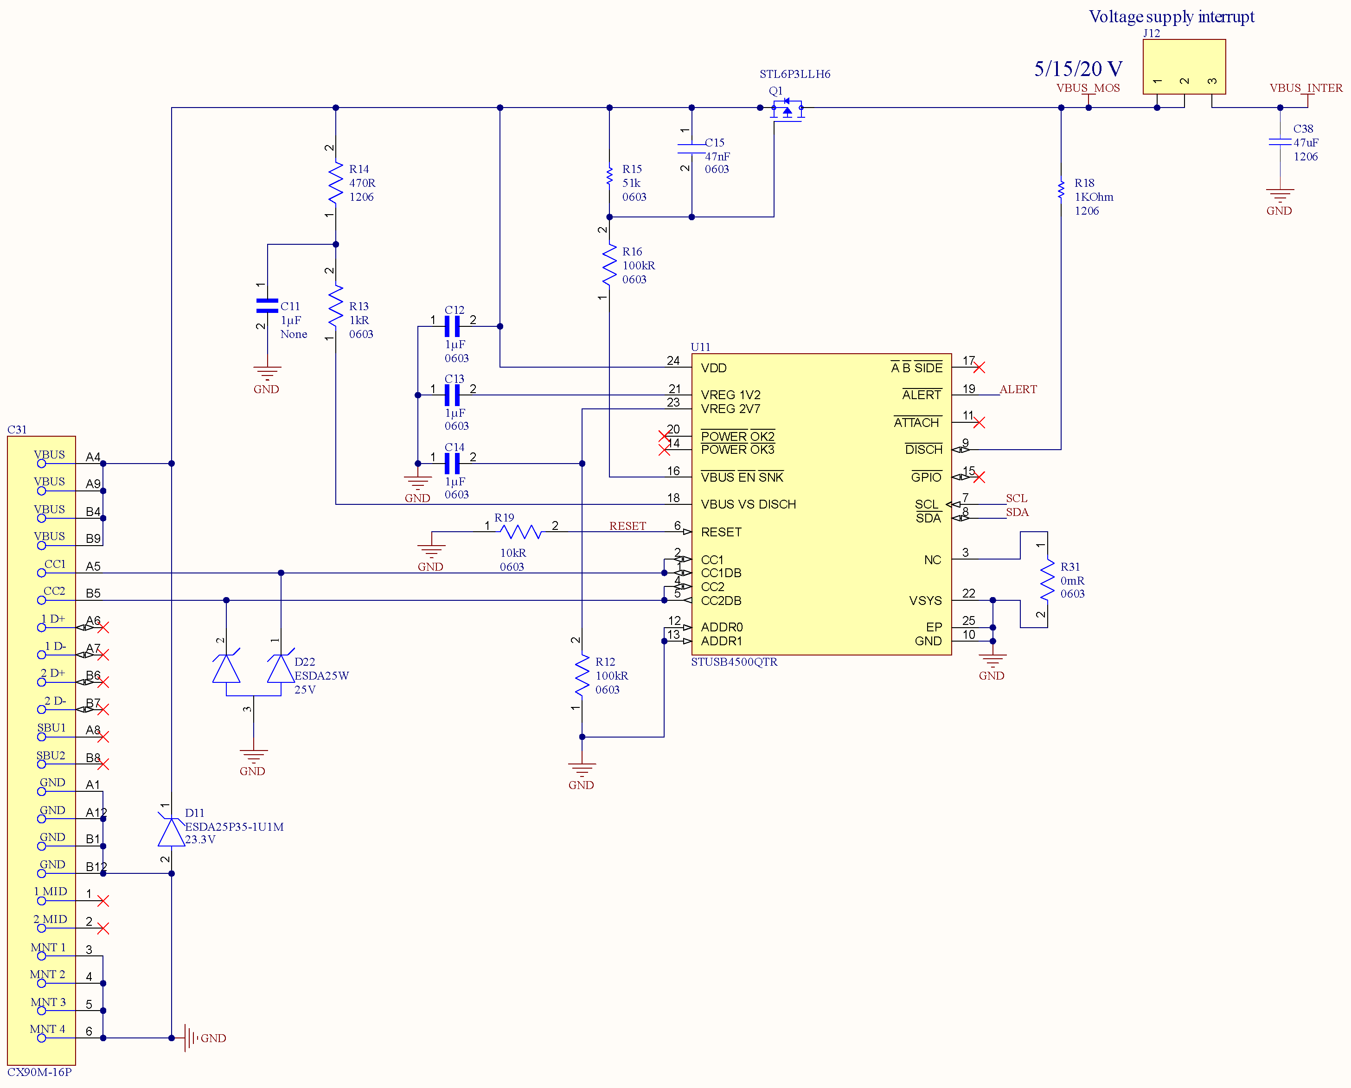
[picture p43: figure]

Abbildung 3.2.: Schaltplan der USB-PD Spannungsversorgung mit STUSB4500 USB-Controller

geschützt, welche diese auf Ground ableitet. Genauso ist die Bus-Spannung, also die eigentliche Versorgungsleitung des Systems vor hohen Spannungsspitzen mit einer Z-Diode mit UBR, max. = 25,8 V geschützt.

Der VBUS_VS_DISCH-Eingang des USB-Controllers misst die Eingangsspannung UBus. Da der Eingang auf IVBUS_VS_DISCH, max. = 50 mA und die Spannung UBus durch die Z-Diode auf 25,8 V begrenzt sind, werden zwei Widerstände R13 = 1 kΩ und R14 = 470 Ω in Reihe verwendet. Der maximale Strom für VBUS_VS_DISCH-Eingang beträgt:

IV S_BUS_DISCH =

25, 8V
R13 + R14
= 17, 6mA | (3.1)

Es ergibt sich die maximale Verlustleistung für beide Widerstände:

PV = I

2
V S_BUS_DISCH ∗ R | (3.2)

mit den Verlustleistung R13 = 0,289 W und R14 = 0,136 W. Entsprechend wird R13 mit PV,R13 = 0,33 W und PV,R14 = 0,25 W gewählt.

Der USB-Controller hat zur Schaltung der Leistung den Ausgang VBUS_EN_SNK, welcher mit einem MOSFET verbunden werden kann. Hierfür wird ein P-Channel MOSFET, welches bei Überschreiten einer Threshold Spannung UGS(TH) = 1 V zwischen Source und Gate leitend wird. Bei minimaler Spannung von UBus = 5 V berechnet sich die Gate-Source-Spannung UGS folgendermaßen:

UGS = UBus − UGS(T H) | (3.3)

Dies erlaubt eine maximale Spannung von UGS = 4 V bei UBus = 5 V. Dafür wird ein Spannungsteiler mit Widerständen R15 = 51 kΩ und R16 = 100 kΩ verwendet. Die Ausgangsspannung ergibt sich aus:

UGS = UBus ∗

R16

R15 + R16

(3.4)

Dies ergibt UGS = 3,31 V bei UBus = 5 V. Daraufhin kann die maximal abfallende Spannung UDS aus dem Output Characteristics Diagramm im Datenblatt ablesen.

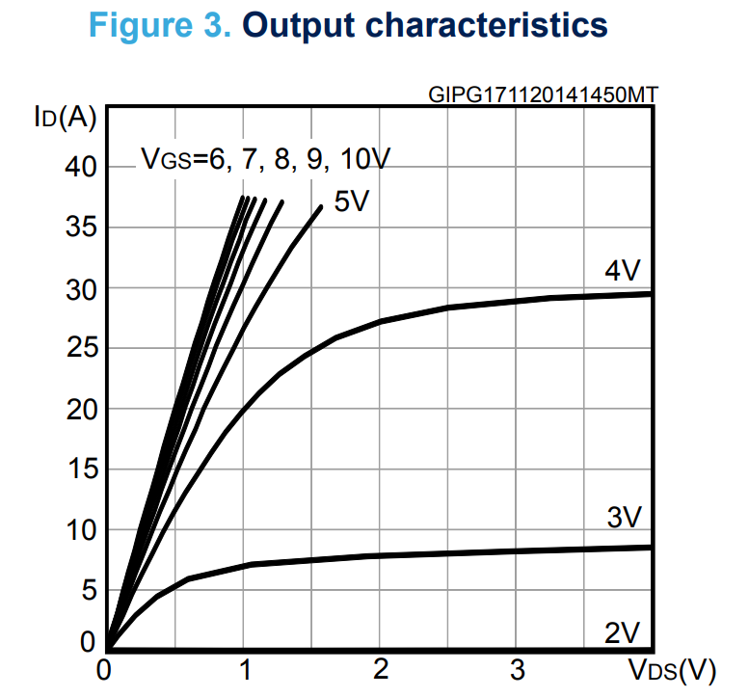
[picture p44: figure]

Abbildung 3.3.: Output Characteristics Diagramm aus [stm.2020]

Bei der kleinsten Spannung UGS = 3,31 V und ID = 3 A beträgt UDS = 0,25 V. Daraus berechnet sich die Verlustleistung im MOSFET PV = 0,75 W:

PV,MOSF ET = UDS ∗ ID | (3.5)

Zum langsamen Schaltens des MOSFETs wird ein Kondensator parallel zum Eingangswiderstand R15 verwendet. Dieser ist anders als in der Referenzapplikation im Datenblatt [stm.2022] gewählt und verbaut. Dies wird im nachfolgenden in der Schaltungssimulation genauer erläutert.

### 3.1.1. Schaltungssimulation

Zur Simulation des Einschaltens des MOSFETs sowie einer Vereinbarung eines Power Contracts wird diese mit einer Transient-Response-Analyse in LT-Spice simuliert. Hierfür wird von einem Anschließen des Steckers mit der standardmäßig zuerst anliegenden UBus = vSafe5V und einem Wechsel auf VBus = 20V nach [usb.2023] ausgegangen. Dies stellt die normale Einschaltroutine mit Vereinbarung eines Power-Contracts dar. In LT-Spice wird nachfolgender Schaltkreis 3.4 entsprechend nach Referenzapplikation laut Datenblatt [stm.2022] angelegt. Für den Power-MOSFET wird ein vergleichbarer MOSFET mit ähnlicher RDS,on gewählt. Die Spannungsquelle besteht aus zwei reihengeschalteten Spannungsquellen. Zur Simulation der Last befinden sich zwei Ersatzwiderstände sowie der Kondensator C38 auf der Drain Seite des MOSFETs.

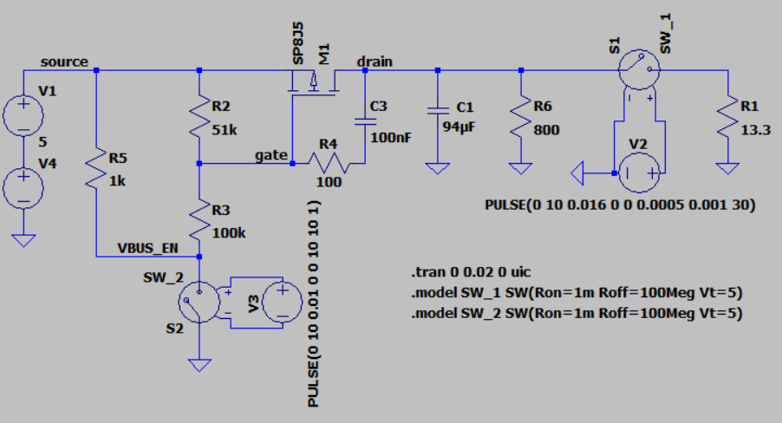
[picture p45: figure]

Abbildung 3.4.: Schaltungsaufbau nach Referenzapplikation [stm.2022]

Die UBus beträgt direkt 5 V und wird nach 5 ms mit der maximalen Steigungsrate von vSrcSlewPos = 30 mV/µS nach [usb.2023] auf 20 V erhöht. Um das Einschalten des

MOSFETs durch den STUSB4500 zu simulieren, wird nach 10 ms der Schalter SW_2 geschlossen und stellt dabei das Verhalten von VBUS_EN_SNK nach. Die Spannungsverläufe sind in 3.5 gezeigt.

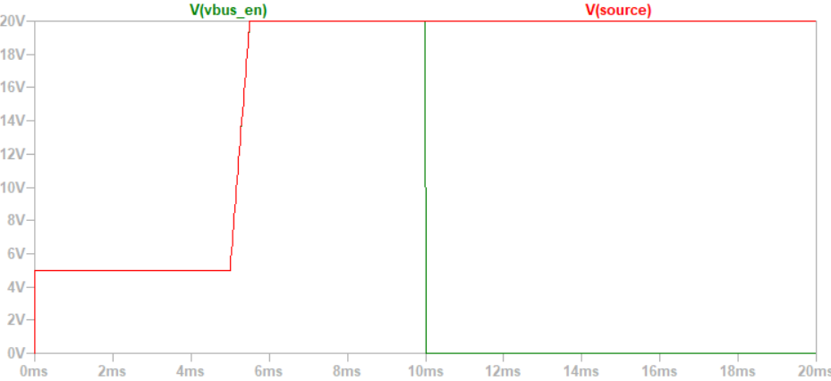
[picture p46: figure]

Abbildung 3.5.: Spannungsverlauf an UBus = V(source) und Einschaltsprung bei 10 ms

Die in der Simulation gemessenen Spannungen sind in nachfolgender Darstellung 3.6 gezeigt. Dabei fällt auf, dass die Spannung V(drain), also die Spannungsversorgung des Systems, mit kurzem Zeitversatz zur Spannungsquelle ebenso bis auf 16 V noch vor t = 6 ms ansteigt, obwohl das Einschaltimpuls erst bei t = 30 ms gegeben wird. Danach fällt die Spannung ab und steigt erst mit dem Einschaltimpuls wieder an bis knapp unter die angelegte Spannung UBus = 20 V. Diese Selbstaktivierung des MOSFETs ist keine gewünschte Funktion der Schaltung und stellt eine Fehlfunktion dar. Es könnte möglicherweise Komponenten gefährden, wenn diese noch gar nicht bereit zum Empfangen einer hohen Spannung sind. Aus diesem Grund muss die Schaltung so geändert werden, dass dieses Selbsteinschalten verhindert wird.

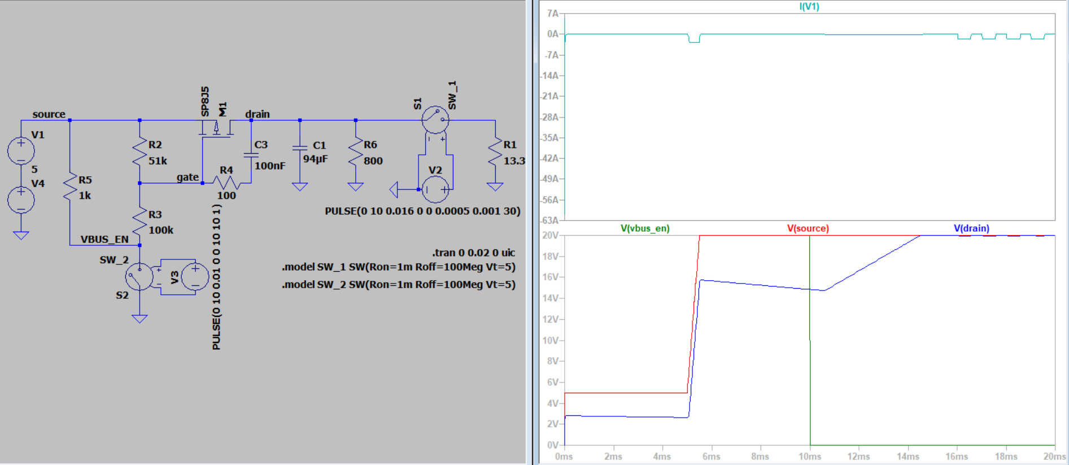
[picture p47: figure]

Abbildung 3.6.: Transienten-Simulation der Referenzapplikation mit Selbsteinschalteffekt des MOSFETs bei t = 0ms und t ≈ 5 ms

Das Selbsteinschalten entsteht dadurch, dass die Gate-abgewandte Seite des Kondensators beim Einschalten auf Ground bzw durch einen ersten Einschaltimpuls durch 5 V auf einer niedrigeren Spannung ist. Folgende Erklärungen können in Abbildung 3.7 beobachtet werden. Da der Kondensator nicht so schnell geladen wird, wie die Spannung steigt, entsteht eine Spannungsdifferenz zwischen Source und Gate (Δzwischen V(source) und V(n004) = UGate), welche den MOSFET aktiviert. Erst wenn der Spannungsanstieg stoppt, wird die Spannung am Kondensator ausreichend hoch, dass die Gate-Source-Threshold Spannung unterschritten wird bei t = 5,5 ms und der MOSFET wieder öffnet.

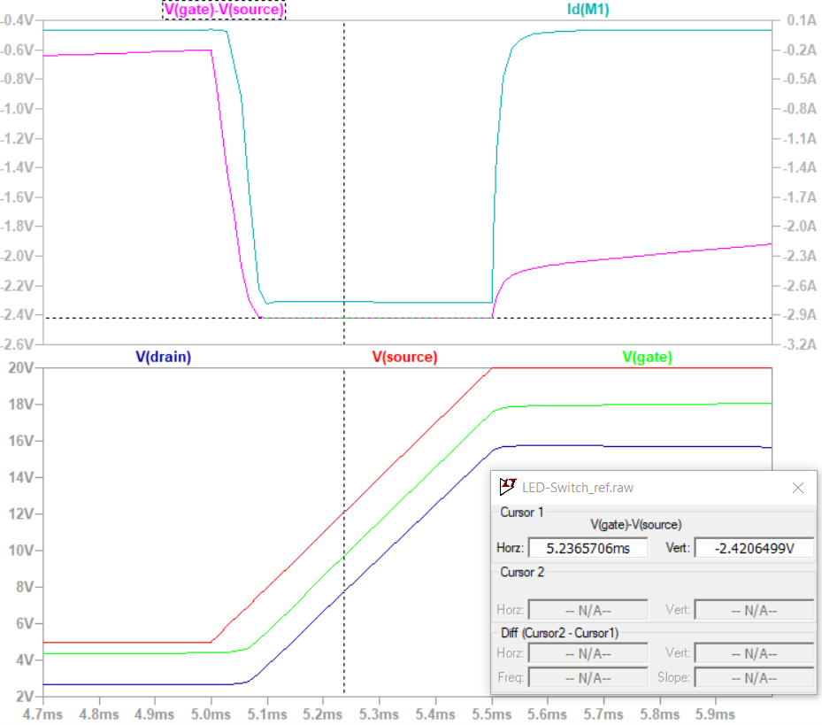
[picture p48: figure]

Abbildung 3.7.: Detailansicht der Simulation mit errechnet UGS oben

Dieses Verhalten wird durch Abändern der Schaltung auf folgende Konfiguration 3.8 geändert. Der Kondensator ist nun parallel und wird bei Anstieg der Spannung an Source nicht geladen, da das Potential auf beiden Seiten des Kondensators steigt.

Korrekterweise steigt die Drain-Spannung dann erst nach dem Einschaltsignal bei t = 30 ms, wie in Simulation 3.9 sichtbar wird. Innerhalb von 2 ms wird der Sprung von 0 V auf 20 V erreicht. Auch die Gate-Source-Spannung, welche für das Schalten des MOSFETs entscheidend ist, steigt in 3.10 eindeutig erst nach 30 ms über die Threshold Spannung.

### 3.1.2. Leistungsberechnung

Die Standbyleistung Pstandby = 3,1 W berechnet sich mit PU22 = 1,3 W und PESP,max = 1,8 W:

Pstandby = PU22 + PESP,max | (3.6)

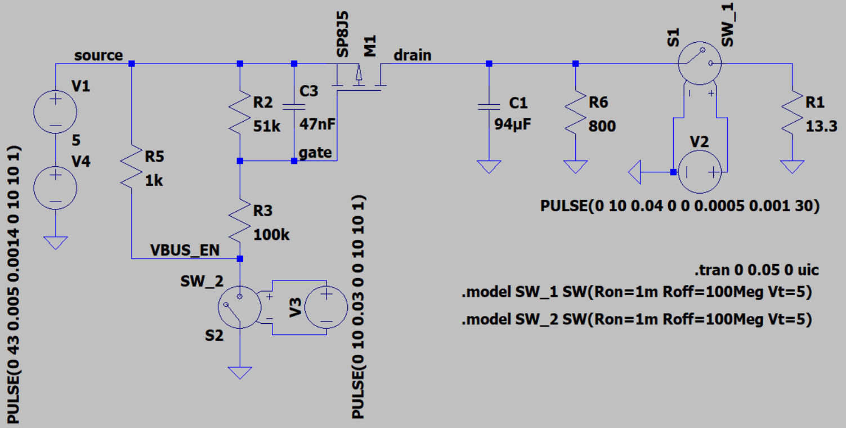
[picture p49: figure]

Abbildung 3.8.: Eigener Schaltungsaufbau mit geänderter Gate Konfiguration am MOSFET

Die Maximalleistung Pmax ≈ 37,4 W berechnet sich mit Pstandby = 3,1 W, ILED = 2 A, URed = 3,6 V, UGBW = 3,9 V, PV,P-MOS = 0,27 W und ηT reiber = 0,9:

Pmax = Pstandby + PV,P −MOS +

ILED ∗ (URed + 3 ∗ UGBW )

ηT reiber

(3.7)

Für den Widerstandsteiler berechnet sich die Verlustleistung mit 3.2 und IC15,max für PV,R15 ≈ 7,7 mW bei nach Bauteildatenblatt erlaubten 100 mW. R17 sieht bei einem kleineren Widerstandswert als R15 ein niedrigere PV als dieser. Für den zweiten Widerstand folgt PV,R15 ≈ 8,9 mW bei erlaubten 100 mW.

PV =

(UBus,max ∗

R15
R15+R16

)

2
R15

(3.8)

Die Erhitzung des Gehäuses um ΔT ≈ 34 K durch die umgesetzte Leistung PV errechnet sich durch den Wärmewiderstand des MOSFETs RThj-case = 2,5 K/W und RThj-pcb = 42,8 K/W:

∆T = (RT hj−case + RT hj−pcb) ∗ PV | (3.9)

Wenn sich das Gehäuse auf TGeh = 40 °C aufheizt, bedeutet das eine Temperatur des MOSFETS von Tmax. = 74 °C:

TBetr = TGeh + ∆T | (3.10)

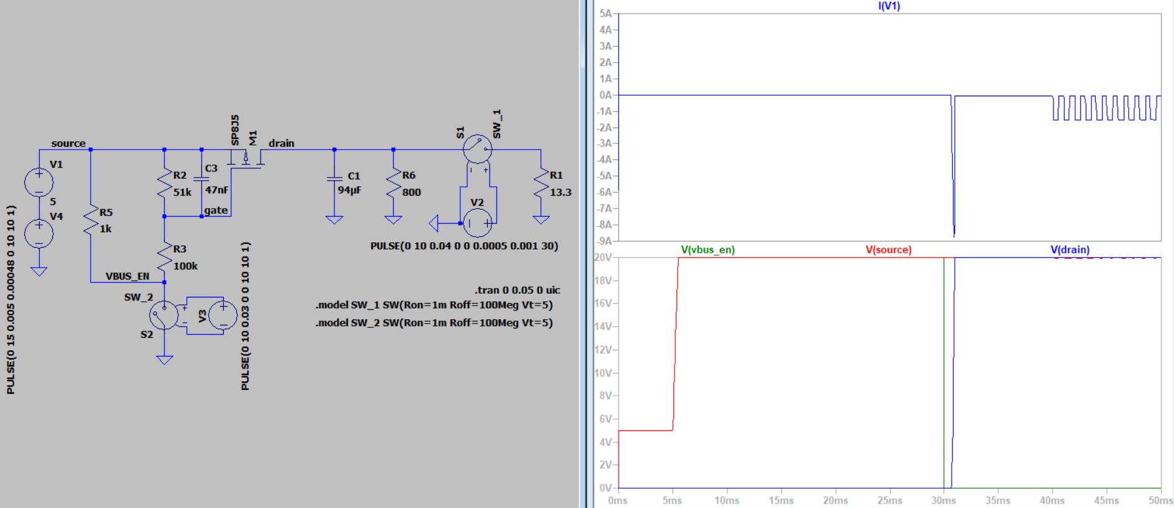
[picture p50: figure]

Abbildung 3.9.: Simulation des eigenen Schaltungsaufbaus mit Einschaltsignal bei t = 30 ms

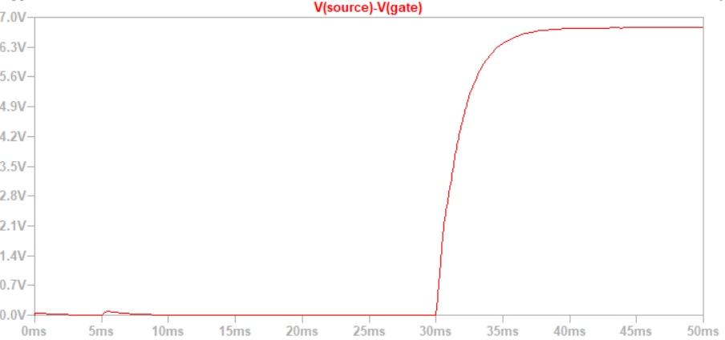
[picture p51: figure]

Abbildung 3.10.: Gate-Source-Spannung am MOSFET mit Einschalten bei t = 30 ms

Aus dem Diagramm Normalized V[U]DS vs. Temperature lässt sich bei maximal zulässigen Temperatur TJ der Faktor 1,08 für UDS ablesen. Dies bedeutet mit 3.5 eine maximale Verlustleistung PV,max = 0,81 W, dies ist laut Datenblatt im zulässigen Bereich. Außerdem hat eine höhere Temperatur des MOSFETs nach Normalized gate threshold voltage vs temperature Diagramm eine niedrigere Threshold Voltage als Auswirkung. Dies erhöht die Schaltungszuverlässigkeit des MOSFETs auch bei kurzzeitigen kleinen Spannungseinbrüchen. Bei maximaler Betriebsspannung UGS = 20 V lässt sich aus dem Diagramm Output Characteristics Diagramm UDS = 0,1 V ablesen. Dies hat nach 3.5 eine noch geringere Verlustleistung zur Folge.

Um die Kapazität der LED-Steuerung bei Ausschalten zu entladen, wird der DISCH-Anschluss des USB-Controllers mit einem 1 KΩWiderstand zur Begrenzung des Entladestroms verbunden. Der NC-Anschluss ist laut Datenblatt Floating, laut Referenzapplikation soll dieser aber zur Verhinderung ungewünschter Spannungen am Eingang auf Ground gezogen werden.

### 3.1.3. I2C Verbindung des USB-PD Controller und Mikrocontroller

Nachfolgend wird der Mikrocontroller ESP32 und dessen Verbindungen und Schaltung (s. Schaltplan Abbildung 3.11) behandelt.

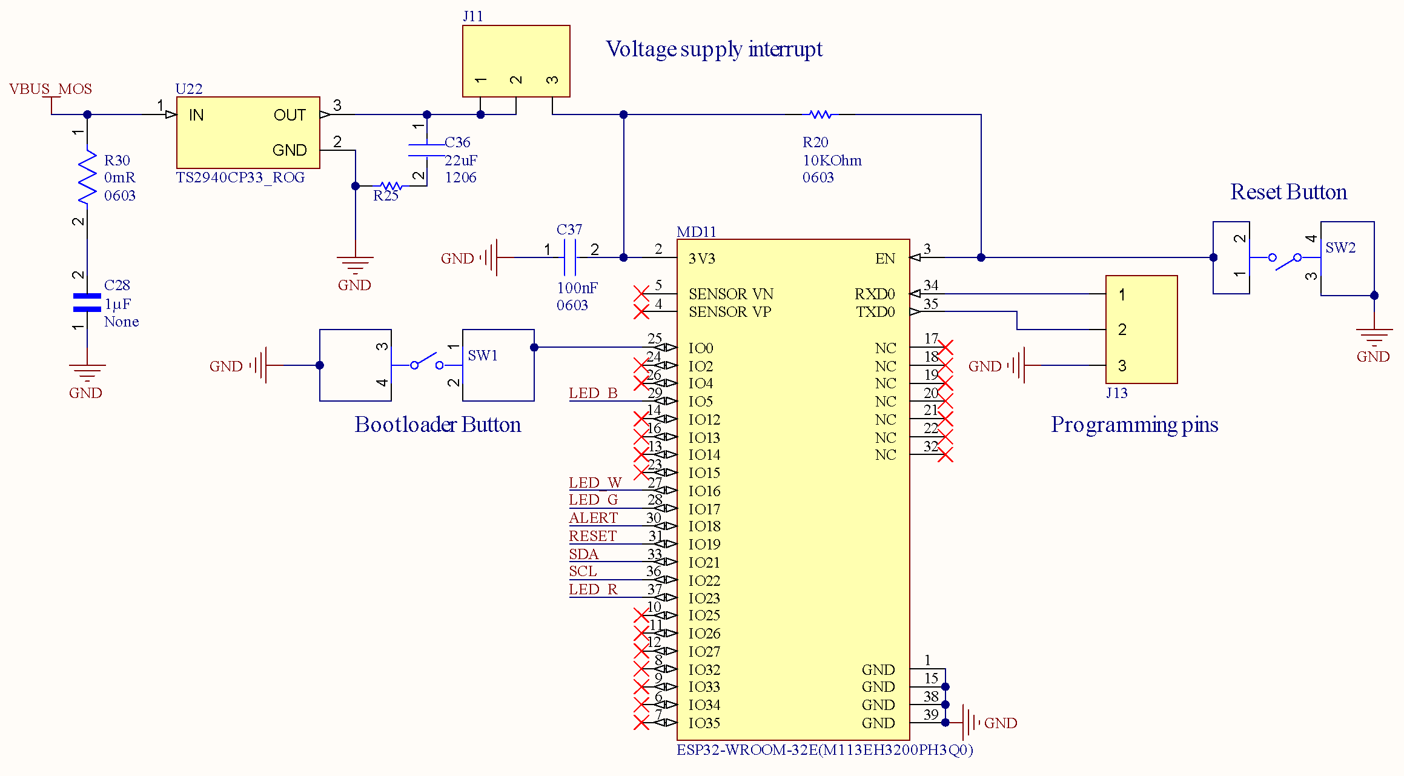
[picture p52: figure]

Abbildung 3.11.: Schaltplan des ESP32 und Spannungsversorgung

Für die Programmierung des USB-Controllers wird dieser mit den beiden für I2C notwendigen Serial Clock (SCL) und Serial Data (SDA) Pins des Mikrocontrollers verbunden. Um einen Reset des USB-Controllers über den Mikrocontroller zu ermöglichen, wird der Reset Pin des STUSB45000 mit einem 10K-Pull-Down-Widerstand auf Ground gezogen. Im Reset Fall kann der Reset Pin des USB-Controller vom ESP auf Logic-Level gehoben werden. Zusätzlich wird der Alert-Pin des USB-Controllers mit dem IO18-Eingang des Mikrocontrollers verbunden, um einen Fehler bei der Vereinbarung des Power-Contracts zu melden.

Beim USB-Controller kann zwischen vier I2C Adressen gewählt werden. Dafür können zwei Bits der 7-Bit Adresse über das Spannungsniveau entsprechend gesetzt werden. Dafür werden beide Pins auf Logic-Level 2.7 V gehoben. Der Widerstand R12 = 100KΩ begrenzt den Strom nach folgender Formel auf IR12 = 27 µA. Somit ist die I2C Adresse laut Datenblatt 0x2B.

I =

U
R

(3.11)

## 3.2. Mikrocontroller ESP32

Zur Steuerung der LEDs wird ein ESP basierter Mikrocontroller ESP32-WROOM-E verwendet. Dieser benötigt zur Spannungsversorgung U3V3 = 3,3 V, welche mit einem 100nF Kondensator C37 direkt am Spannungseingang stabilisiert wird. Dieser wird von einem TS2940CP33 Spannungsregler betrieben. Dieser benötigt nach Datenblatt einen 1 µF Eingangskondensator und einen 22 µF Ausgangskondensator. Um für den Ausgangskondensator auf einen Tantalkondensator verzichten zu können, wird ein 0.2 ΩWiderstand zur Erhöhrung des Ersatzreihenwiderstand (ESR) verwendet. Laut Datenblatt des TS2940CP33 muss der 0.1 Ω< ESR < 2 Ω. Da beim Eingangskondensator der benötigte ESR nicht definiert ist, wird ein 0 Ωeingebaut, um diesen auf der Platine noch anpassen zu können.

Um den Mikrocontroller programmieren zu können, werden die UART Pins Receiving Pin UART (RX) und Transmitter Pin UART (TX), sowie der Ground auf einen 3 Pin Buchse gezogen. Dies ermöglicht zusammen mit zwei Tastern für Aktivierung des Bootloaders und Reset des ESPs die Programmierung des ESPs von einem externen PC. Der Enable Pin des ESP wird dafür auf mit einem Pull-Up Widerstand auf Logiklevel gehoben und beim Reset zu Ground kurzgeschlossen. Da aus dem Datenblatt nicht eindeutig hervorgeht, ob der Not Connected (NC)-Pin floating sein muss oder auf Ground gezogen werden darf, wird dieser mit einem 0 ΩWiderstand auf Ground gezogen. Dies ermöglicht im Nachhinein das Einbauen eines Widerstands, sollte die Schaltung so nicht funktionieren.

## 3.3. LED-Beleuchtungstreiber

Es wird die RGBW-LED SBM-40-RGBW-SC41-QD100 LED mit einem maximalen Eingangsstrom von ILED = 2A verwendet. Die Helligkeit der 4 LEDs wird durch Pulsweitenmodulation (PWM) bei einer Frequenz von 1kHz gesteuert. Um ein für den Menschen wahrnehmbares Flimmern im Punkt des schärfsten Sehens zu verhindern, würde eine PWM-Frequenz von
50 Hz reichen. In den äußeren Sichtbereichen des Auges ist die menschliche Wahrnehmung
für höhere Frequenzen empfindlicher und auch weit mehr als 100 Hz können je nach Individuum wahrgenommen werden. Aus diesem Grund wird eine Frequenz von 1 kHz gewählt.

Als passender LED-Beleuchtungstreiber wird der TS19503CB10H_RBG ausgewählt. Jeder Integrated Circuit (dt. Integrierter Schaltkreis) (IC) ermöglicht die Ansteuerung einer Farbe. Die Eingangsspannung des IC liegt aufgrund der Spannungsvariation bei unterschiedlichen USB-P Versionen zwischen UIN = 4.5 − 75V . Es wird eine Dimmung bis zu einem TOF F − TON -Verhältnis von 1000:1 unterstützt.

Der Stromfluss durch die LEDs wird durch einen Widerstand RCS = 50mΩ zwischen dem "CSEingang und "VIN"mit folgender Formel berechnet:

ILED =

0.1V

RCS

(3.12)

Die Verlustleistung des Widerstandes ist somit PV=100mW und unterliegt der Nennleistung von PV,nenn=200mW.
Für die Glättung von Strom-/Spannungsschwankungen befindet sich ein Keramikkondensator mit einer Kapazität von C=47µF zwischen der spannungsführenden Leitung und Ground (GND) mit einer Nennspannung von 25 VDC. Parallel hierzu befindet sich ein weiterer Keramikkondensator, zwei Größenordnungen kleiner C=470nF um eine größere Bandbreite an Filterleistung abzudecken. Zwischen dem VDD-Ausgang und GND wird die interne Betriebsspannung durch einen Keramikkondensator mit C=10µF stabilisiert.

Die Pulse des PWM-Signals werden mit einer Spule von L=10µH abgeglättet. Hierdurch ist es möglich bei einer schnellen Schaltung einen geringeren, aber konstanten Stromfluss zu erreichen und somit flimmern der LED zu verhindern. Die Schottky-Diode zwischen VDD und LX dient dem Schutz des ICs vor einem höheren Spannungspotenzial am LX-Ausgang im Bezug zu VIN. Steigt die Spannungsdifferenz auf die Durchlasspannung von UF,Typ=420mV an, so schaltet die Diode durch. EXP, AGND und PGND werden an den Ground angeschlossen. Alle nicht-erwähnten PINs werden schwebende Anschlüsse.

Ein Problem des verwendeten Schaltnetzteils ist die Zweipunktregelung zur Einstellung des Ausgangsstromes. Hierfür gibt es modernere Bauteile, die durch eine bessere Regelung z.B. unter Nutzung eines PID-Reglers einen stabilen Ausgangsstrom auch auf Mikroebene im Bauteil erzeugt. Des Weiteren ist die Regelung des Ausgangsstromes nicht GNDbasiert. Dies stellt einen Nachteil im Wärmemanagment und Layout dar, da man so einen gemeinsamen Ground verwenden könnte. Dies lässt sich auch durch die Verwendung eines anderen Schaltnetzteils erreichen.

## 3.4. LED-Kühlung

Die maximale Leistung von LEDs ist mit der steigenden Nachfrage an LEDs immer weiter gestiegen. Jedoch steigt mit einer höheren Leistung ebenfalls die Imitation an thermischer Energie. Grundsätzlich kann von der Annahme ausgegangen werden, dass ein Anteil von mehr als 70% in thermische Energie umgewandelt wird [.2019]. Für die ausgewählte LED ist dies in einem Extremfall bei einer maximalen Durchlassspannung der weißen LED von UF,max = 3.9V und einem Tastverhältnis von 100% mit der folgenden Formel eine

Verlustleistung von PV = 7.8W pro LED und einer abgeschätzten thermischen Leistung PT H = 5.46W, die auf 1mm² Emitterfläche abgeführt werden muss:

PV = UF,max · Imax | (3.13)

Das genaue Verhältnis von thermischer Energie und Photonenenergie ist jedoch nicht bekannt. Aus diesem Grund wird der Worst-Case von PV = PT H angenommen. Mit dieser Dimension der Verlustleistung spielt das Temperaturmanagement also ebenfalls eine entschiedene Rolle bei dem Printed Circuit Boards (PCB)-Design. Die Wärmeabfuhr der LED erfolgt durch die Platzierung der LED auf einem externen PCB, das speziell für die Anforderungen der LED designt wird. Mit einem thermischen Widerstand der LED TJC = 1K/W und der thermischen Verlustleistung von PV,ges = 4 · PV = 31.2W, die auf der Fläche AEmitter = 4mm²
emittiert wird, kann der maximale thermische Widerstand berechnet werden, der neben RJC zu dem Kühlsystem hinzugefügt werden kann. Die maximale Temperatur der roten LED Tj.op,red,max = 100řC wird als Referenz verwendet. Daraus lässt sich Rth,max = 1.404K/W berechnen:

Rth,max =

Tjop.,red,max − Tamb

PV,ges

− RJC | (3.14)

Der thermische Widerstand der Elemente von dem LED-Case bis zum Kühler wird mit der Formel

Rth =

d
λ · A

(3.15)

berechnet, wobei die Materialeigenschaft, thermische Leitfähigkeit λ, und die Dimension der Übertragungsfläche A, sowie die Dicke d des Materials einbezogen wird. Im Vergleich zu herkömmlichen FR4-Platinen mit einem thermischen Widerstand Rth ≈ 57K/W bei einer Platinendicke von 1.6mm, besitzt eine IMS-Platine mit Alukern bessere thermische Ableitungseigenschaften. Für die Rechnung wird die Platine von PCB Layout Ltd. verwendet. Die Platine hat eine Gesamtdicke von 1.5mm und besteht aus einer 100µm dicken Isolationsschicht und einer einseitigen Kupferschicht von 35µm Stärke. Daraus folgt eine Aludicke von dALU = 1.365mm. Mit einer Auflagefläche ALED = 25mm² und der thermischen Leitfähigkeit von Kupfer λCu = 380W/mK, sowie der thermischen Leitfähigkeit von Aluminium λAl = 160W/mK, kann der thermische Gesamtwiderstand Rth,P CB = 3.45×10⁻⁴ berechnet

werden. Die Isolationsschicht wird ignoriert, da sie nicht auf die Auflagefläche aufgetragen wird.

Der Standardstrangkühlkörper SK 507 100 SA mit einer Länge von 100mm wird als Katalysator zur Wärmeübertragung an die Umwelt verwendet. Dieser besitzt einen Wärmewiderstand von ungefähr Rth,KK = 0.7K/W. Hinzu kommt der thermische Widerstand von dem Übergang PCB zu Kühlkörper mit einer Wärmeleitpaste Rth,UB = 0.1K/W. Neben dem Wärmewiderstand der LED lässt sich somit ein Gesamtwiderstand von 0.8K/W berechnen und entspricht somit der Anforderung von ≤ 1.4K/W.

# 4. Leiterplattenlayout

Für das Layout der Platine wird Altium Designer verwendet. Alle Bauteile bis auf die LED finden auf einer zweilagigen Platine Platz, wobei überwiegend die untere Lage für GND und die obere überwiegend für die Versorgungsspannungen. Auf der Platine sind drei Stecker, mit welchen die Spannungsversorgungen überbrückt und unterbrochen werden können um einzelne Bereiche der Platine zu testen und die Spannungen zu messen. Außerdem sind die Logikanschlüsse zum ESP mit Vias als Testpunkte auf die Unterseite der Platine geführt. Nachfolgend ist das Layout der Platine mit der Oberseite 4.1, der Unterseite 4.2.

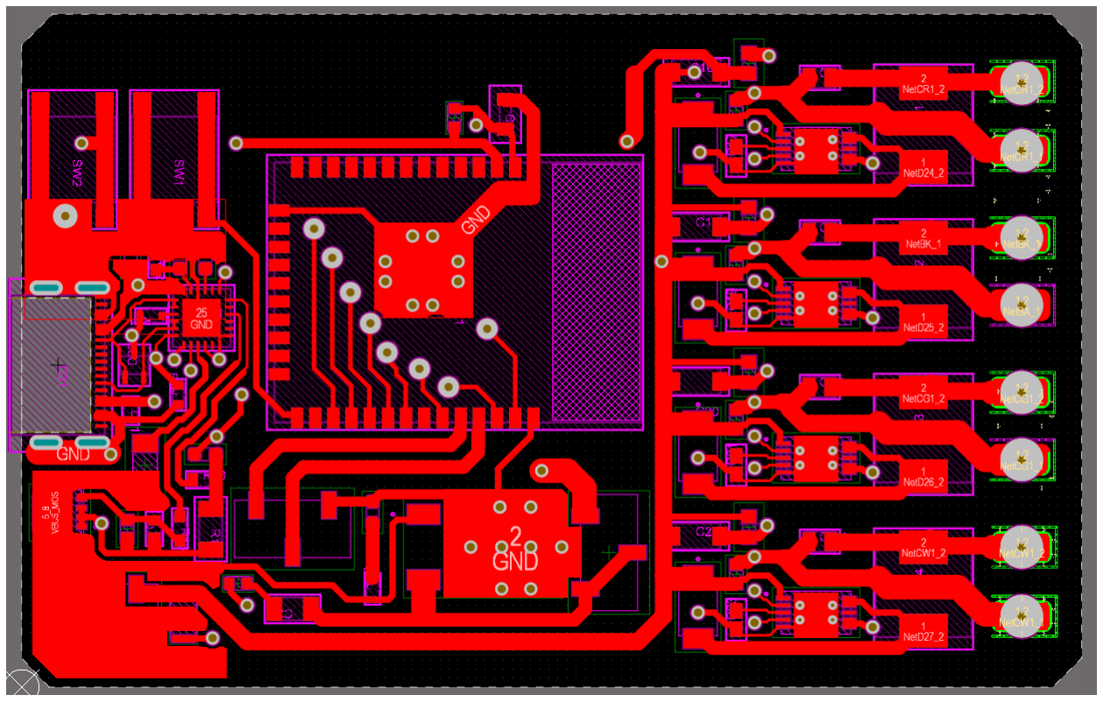
[picture p53: figure]

Abbildung 4.1.: Oberseite der Platine mit leitender Schicht in Rot

In 4.1 ist unten links eine große Kupferkühlfläche zu sehen. Diese kühlt den dort platzierten P-MOSFET. Außerdem sind an den leistungstragenden Bauteilen an den GND-Pads Vias auf die GND-Fläche auf der Unterseite der Platine zur Wärmeableitung gelegt.

In nachfolgender Abbildung 4.2 sind wiederum diese Durchkontaktierungen zu sehen. Besonders relevant ist hierfür die links in der Abbildung sichtbare Trennung von Analogbzw. Power-GND der LED-Treiber. Diese ist zur Stabilisierung der Analogen GND-Referenz für die internen Operationsverstärker im Schaltnetzteil.

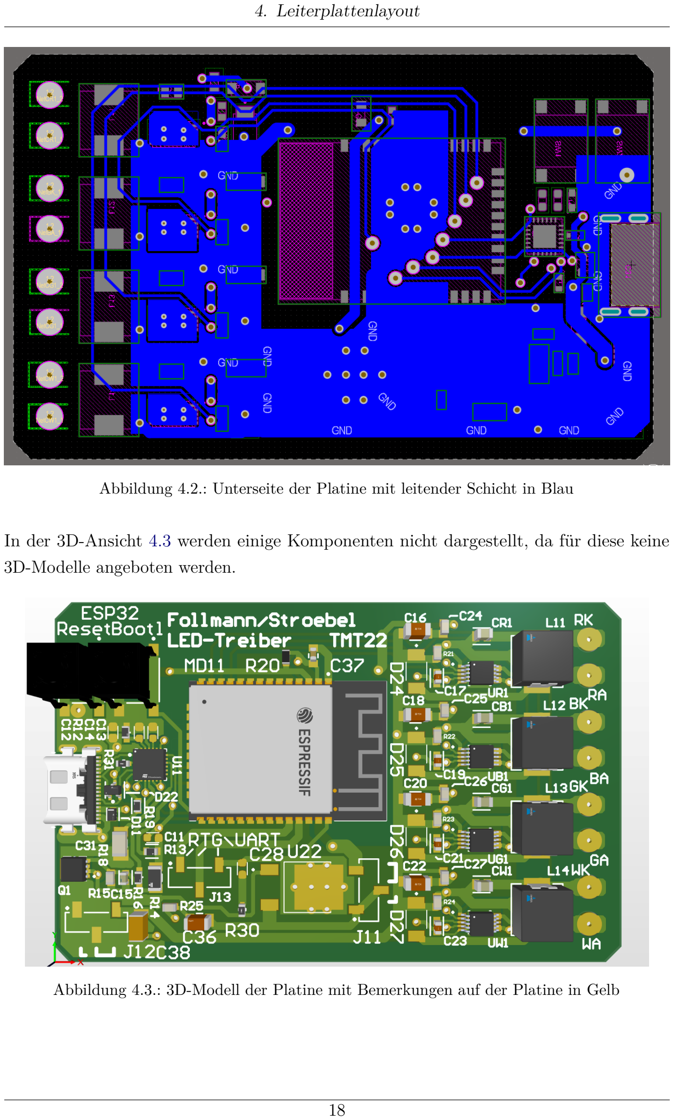
[picture p54: page 24]

4. Leiterplattenlayout

Abbildung 4.2.: Unterseite der Platine mit leitender Schicht in Blau

In der 3D-Ansicht 4.3 werden einige Komponenten nicht dargestellt, da für diese keine 3D-Modelle angeboten werden.

Abbildung 4.3.: 3D-Modell der Platine mit Bemerkungen auf der Platine in Gelb

4. Leiterplattenlayout

Die LED wird auf einer separaten Platine verbaut. Diese ist eine Aluplatine als Anschluss an den Wärmeleitkörper. Nachfolgend ist das Layout dieser Platine zu sehen 4.4.

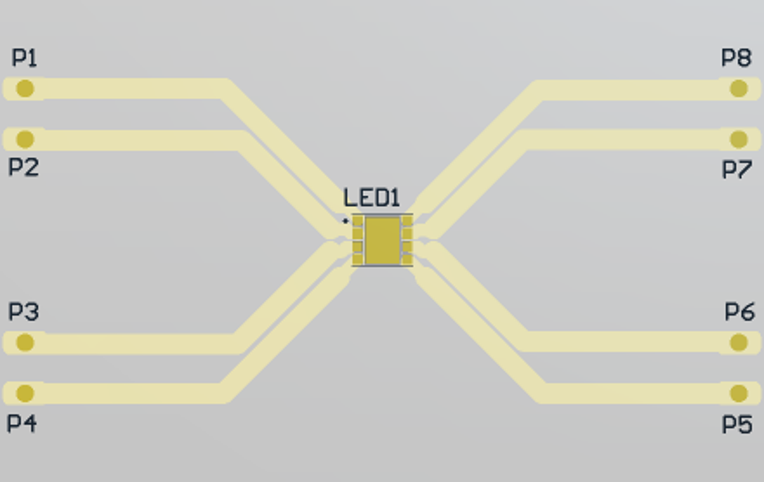
[picture p55: figure]

Abbildung 4.4.: Platine aus Aluminium mit aufgelötetem Stecker

# 5. Ausblick und

# Verbesserungsmöglichkeiten

Die Weiterentwicklung des LED-Treibers öffnet das Tor für zahlreiche innovative Verbesserungen, die bisher nicht umgesetzt werden konnten. Ein zentraler Aspekt ist die Integration einer DMX-Bus-Schnittstelle, die nicht nur eine professionelle und flexible Steuerung des einzelnen LED-Treibers ermöglicht, sondern auch die Vernetzung mehrerer Treiber zu einem koordinierten LED-System unterstützt. Dies erfordert den Einsatz von addressierbaren LEDs, um eine effiziente Steuerung über den DMX-Bus zu gewährleisten. Eine solche Integration würde den Einsatz des Treibers in umfangreichen Bühnensystemen ermöglichen, bei denen eine präzise Kontrolle über komplexe Beleuchtungsarrangements entscheidend ist.
Eine signifikante Verbesserung wäre auch die Einführung einer Schnittstelle für einen Displayanschluss. Ein solches Display könnte wichtige Systemparameter überwachen und anzeigen, einschließlich der Zustände verschiedener Schalter. Diese Erweiterung würde die Bedienung vereinfachen und den direkten Zugriff auf die CPU für grundlegende Anpassungen, wie Helligkeits- und Sättigungsänderungen, überflüssig machen. Ergänzend dazu könnten Status-LEDs implementiert werden, um den Betriebszustand des Systems auf einen Blick zu erfassen und wertvolle Informationen über aktuelle Betriebsmodi oder Systemwarnungen bereitzustellen.
Weitere Entwicklungsmöglichkeiten bestehen in der Erweiterung des LED-Arrays. Ein 6-Farben-Array, das zusätzlich zu den Standard RGBW-Farben auch Amber und UV beinhaltet, würde neue kreative Möglichkeiten in der Lichtgestaltung eröffnen und die Grenzen herkömmlicher Systeme überschreiten.
In Bezug auf die Kühlung könnten nach genauen Temperaturmessungen an einem realisierten PCB Verbesserungen vorgenommen werden. Effizientere Kühlkörper, sowohl auf der Treiber- als auch auf der LED-Board-Seite, sind vorgesehen, um eine optimale Wärmeabfuhr für alle Komponenten zu gewährleisten. Dies würde die Langlebigkeit und Zuverlässigkeit des Systems wesentlich erhöhen.
Abschließend ist geplant, eine neuere Version der ESP-CPU zu integrieren. Diese Aktualisierung soll einen wesentlichen Bestandteil des Systems modernisieren und dessen Leistungsfähigkeit in Bezug auf verschiedene Parameter, die durch diese Systemerneuerung beeinflusst werden, steigern.

# Anhang

## A. Bauteile und Schaltplan

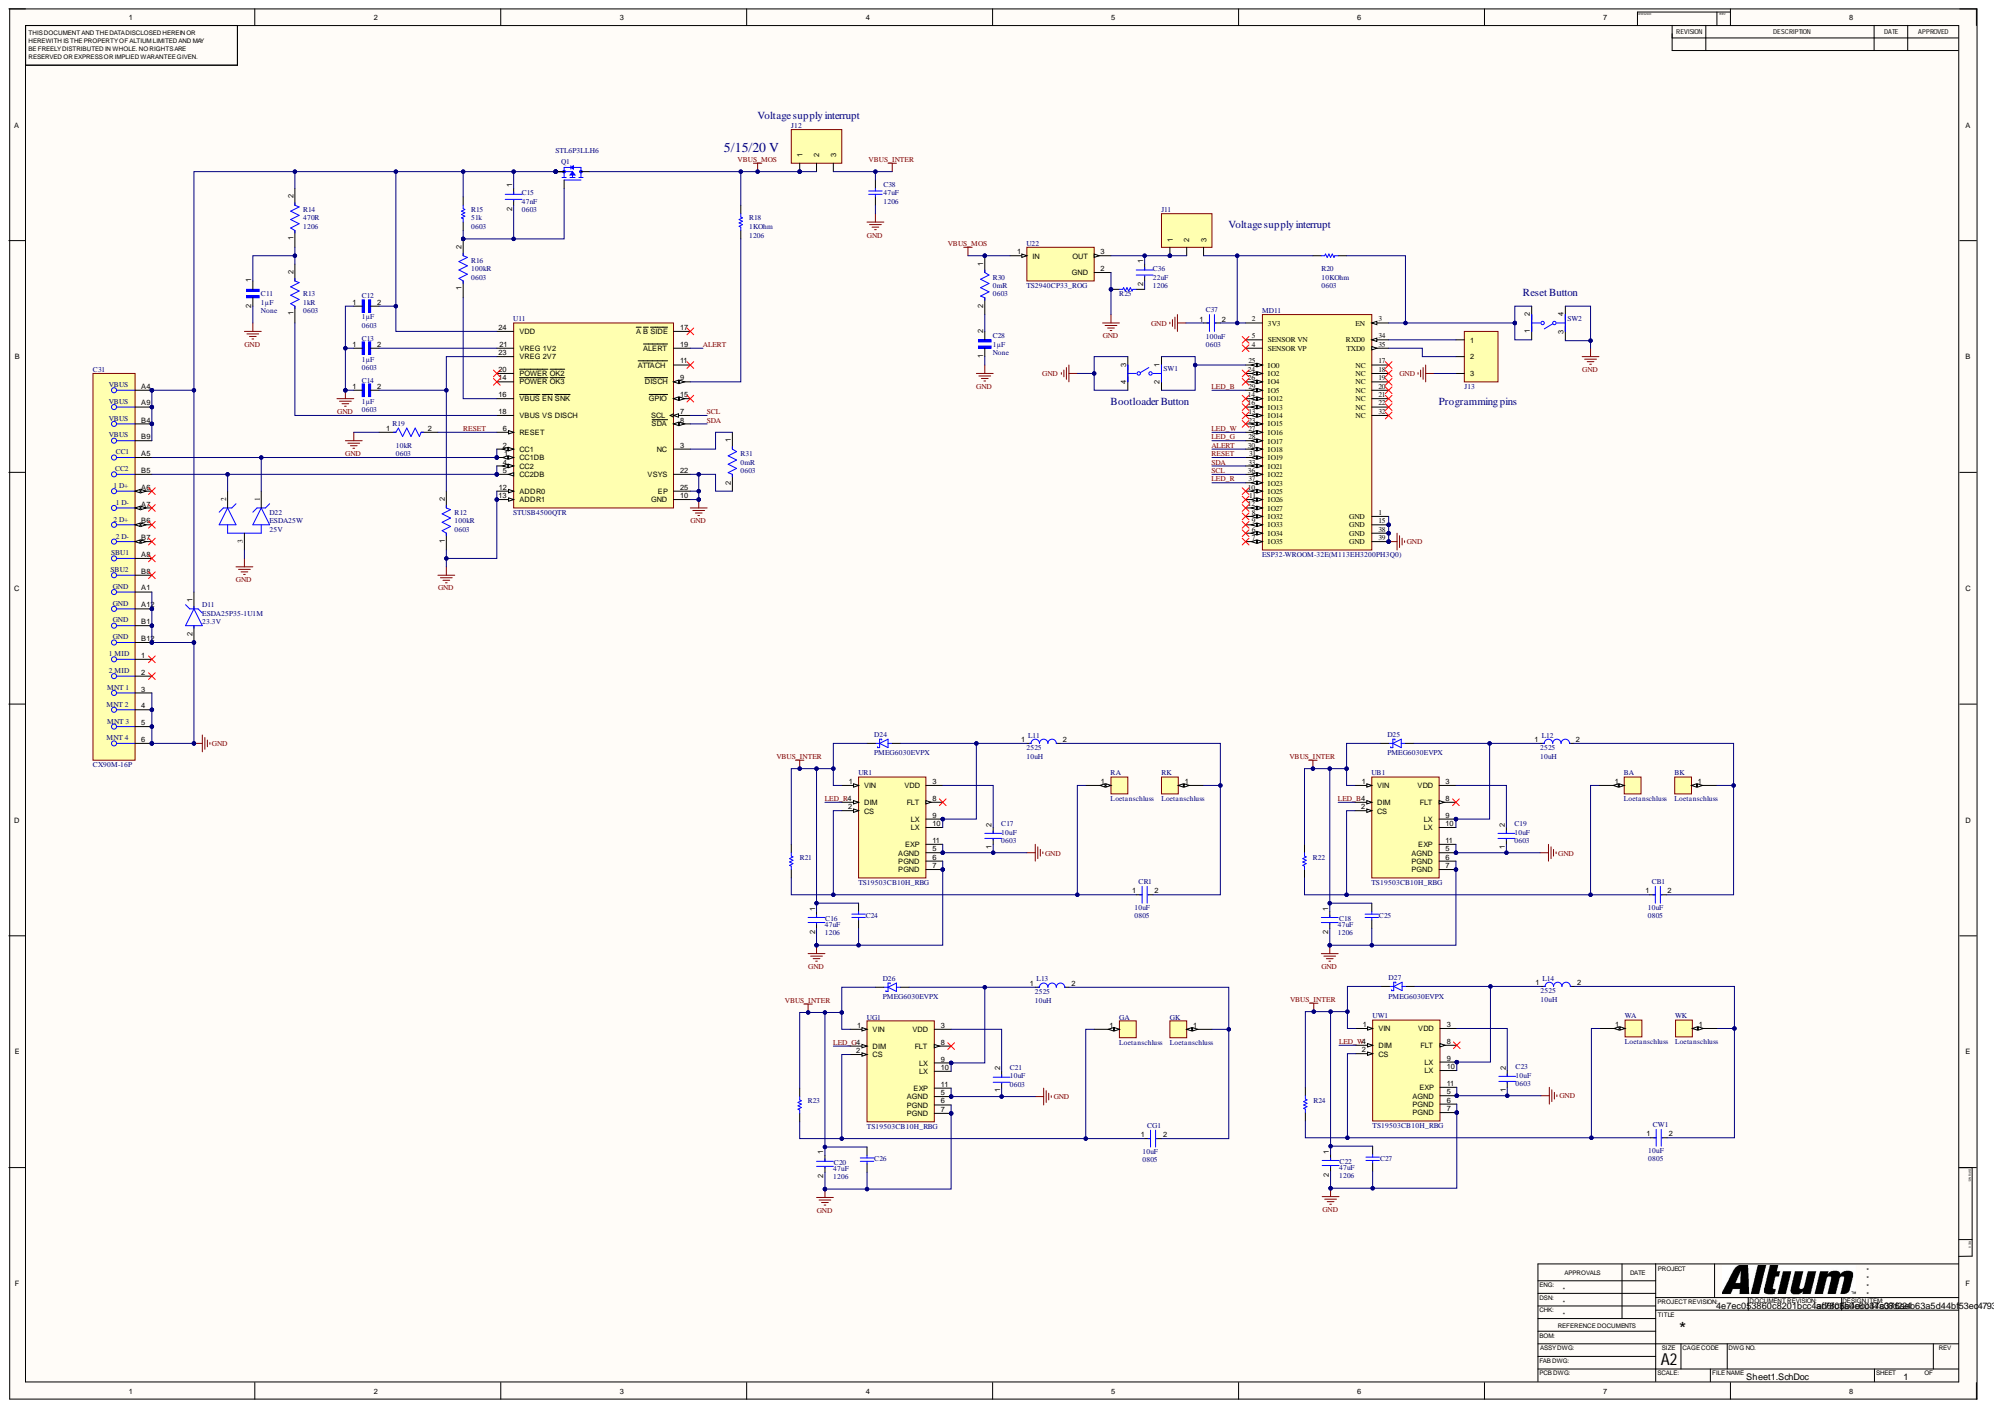
[picture p56: page 28]

DWG NO: | REV:

THIS DOCUMENT AND THE DATADISCLOSED HEREIN OR HEREWITH ISTHE PROPERTYOF ALTIUM LIMITED AND MAY BEFREELY DISTRIBUTED IN WHOLE. NO RIGHTSARE RESERVED OR EXPRESSOR IMPLIED WARANTEEGIVEN. | STL6P3LLH6 Q1 | REVISION | DESCRIPTION | DATE | APPROVED

DATE | PROJECT | * * APPROVALS * *

ENG: *
CHK: * | | TITLE *

DSN: * | | PROJECT REVISION: | DOCUMENT REVISION: | DESIGN ITEM:
