jostroeb/hpower_LED_driver/Simulation/Draft1.asc

I2: current; ""; AC 1
L1: ind; 100µ
R1: res; 1.95
Named nets: 0
;tran 0 0.1 0 uic
.ac dec 05 1 20000
