jostroeb/hpower_LED_driver/Simulation/LED-Switch.asc

C1: cap; 94µF
C3: cap; 47nF
M1: pmos; SP8J5
R1: res; 13.3
R2: res; 51k
R3: res; 100k
R5: res; 1k
R6: res; 800
S1: sw; SW_1
S2: sw; SW_2
V1: voltage; 5
V2: voltage; PULSE(0 10 0.04 0 0 0.0005 0.001 30)
V3: voltage; PULSE(0 10 0.03 0 0 10 10 1)
V4: voltage; PULSE(0 15 0.005 0.00048 0 10 10 1)
Named nets: 0, gate, VBUS_EN, source, drain
.tran 0 0.05 0 uic
.model SW_1 SW(Ron=1m Roff=100Meg Vt=5)
.model SW_2 SW(Ron=1m Roff=100Meg Vt=5)
