jostroeb/hpower_LED_driver/Simulation/P-MOS-Charge.asc

C1: cap; 100n
R1: res; 51k
R2: res; 100k
R3: res; 100
V1: voltage; 20
Named nets: 0
.tran 0 100ms 0 uic
